janblumenkamp/rcj2015/CAD/Liste_aller_Teile.odt

Wenn nicht anders unter Bemerkung gekennzeichnet soll aus transparentem Plexiglas geschnitten werden.

Bezeichnung Dateiname Stärke Anzahl Bemerkung

Kitdropper:

- Seitenwand k_s.dxf 3mm 2x

- Seitenwand_dist k_d.dxf 3mm 2x

- Vorderwand k_v.dxf 3mm 2x

- Befestigungsleiste k_bef.dxf 3mm 2x

- Dropper k_drp.dxf 5mm 1x

- Servohalter k_srv.dxf 3mm 1x

- Rescuekits k_kit.dxf 6mm 12x farbiges Plexiglas!

- ca. 0.012m² in 3mm Stärke

- ca. 0.0013m² in 5mm Stärke

- ca. 0.00246m² in 6mm Stärke

Untere Ebene (lowerstage):

- Ebene l_e.dxf 6mm 1x

- SRF10 Halter siehe mittlere Ebene

- Sharp Senshalter s siehe mittlere Ebene

- ca. 0.0247m² in 6mm Stärke

Mittlere Ebene (middlestage):

- Ebene m_e.dxf 3mm 1x

- Sharp Senshalter l m_shl.dxf 3mm 6x

- Sharp Senshalter s m_shs.dxf 3mm 5x

- SRF10 Halter m_srf.dxf 3mm 3x

- ca. 0.05m² in 3mm Stärke

Obere Ebene (upperstage):

- Ebene u_e.dxf 4mm 1x

- ca. 0.0361m² in 4mm Stärke

GESAMT:

- ca. 0.07m² in 3mm Stärke

- ca. 0.0361m² in 4mm Stärke

- ca. 0.0013m² in 5mm Stärke

- ca. 0.03m² in 6mm Stärke

INSGESAMT ca. 0.14m²
