janblumenkamp/rcj2015/CAD/Schneiden/upperplate/upperplate.png

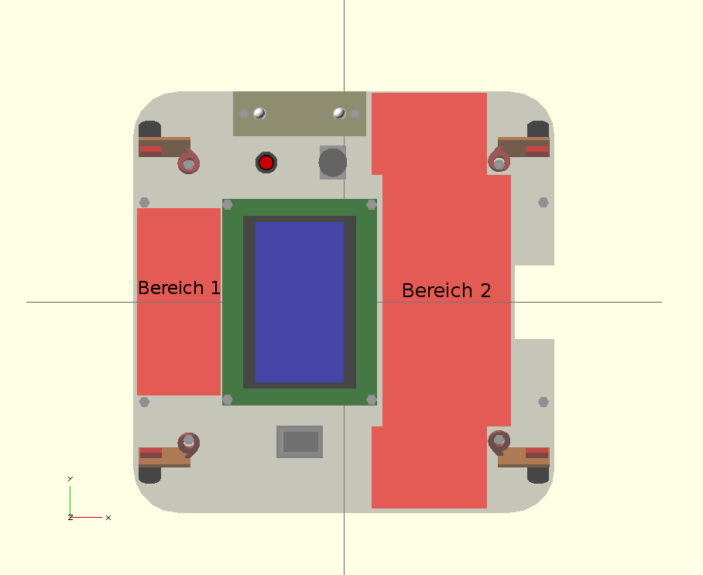
CAD/Schneiden/upperplate/upperplate.png
