janblumenkamp/rcj2015/Doku/Schaltplan/adcexpansion.png

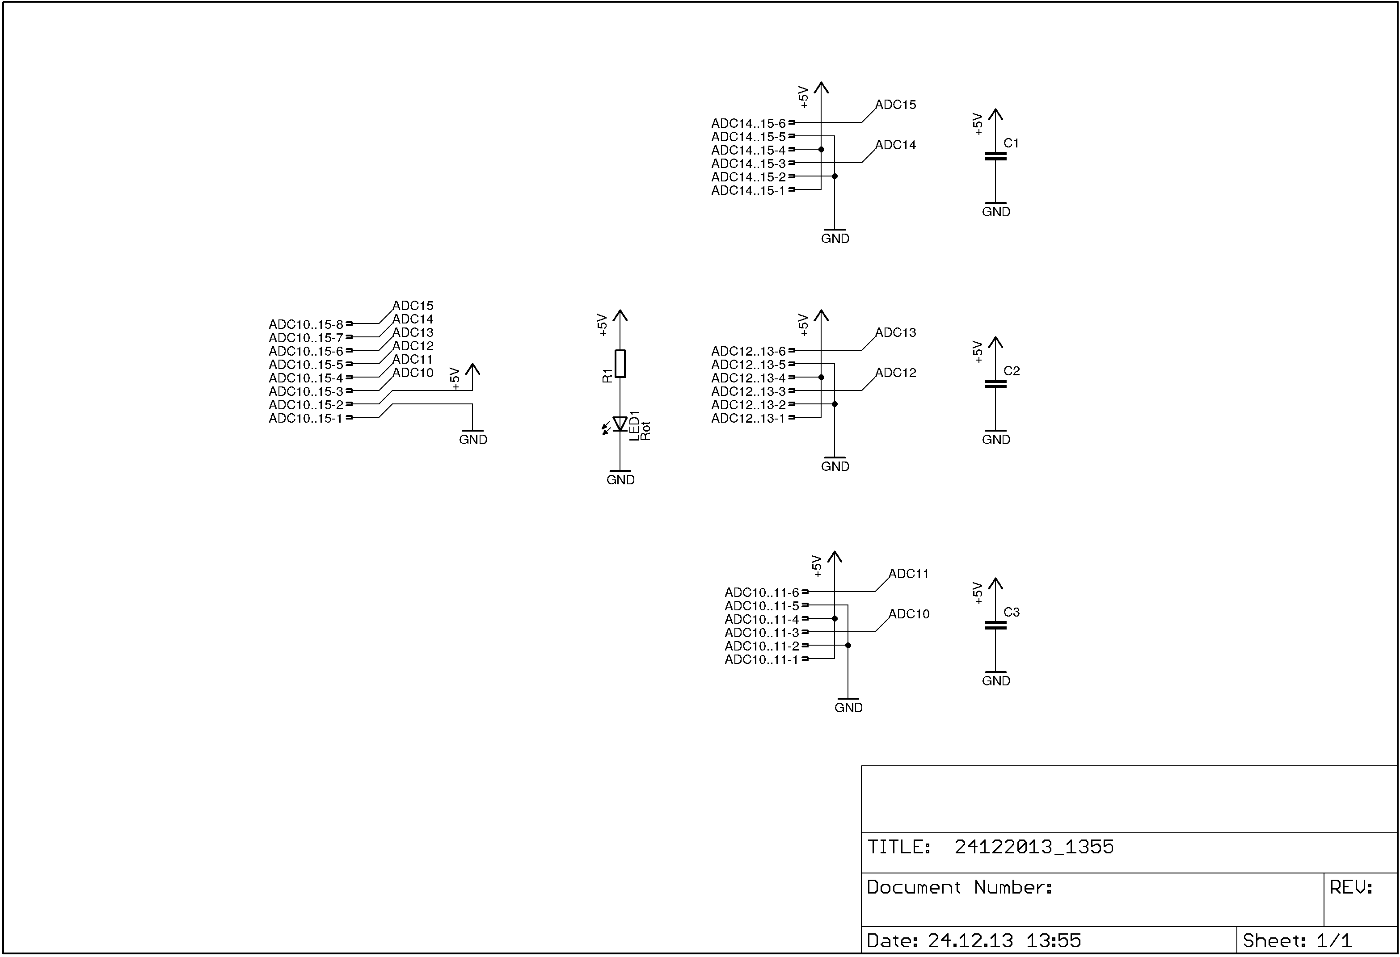
Doku/Schaltplan/adcexpansion.png
