janblumenkamp/rcj2015/Doku/Schaltplan/mainboard.png

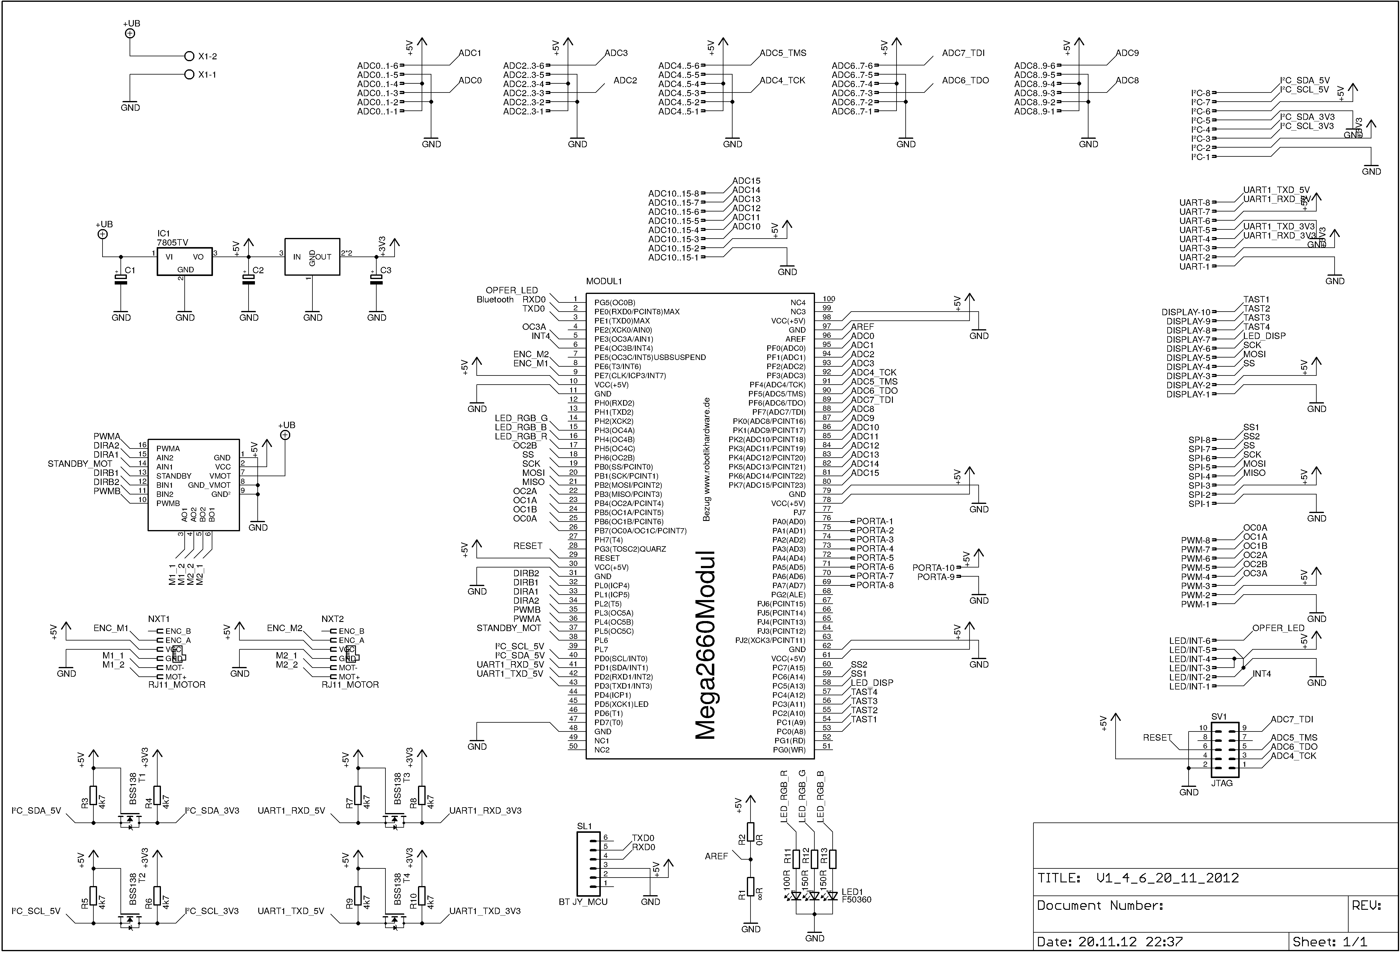
Doku/Schaltplan/mainboard.png
