janblumenkamp/rcj2015/Doku/Schaltplan/powerunit.png

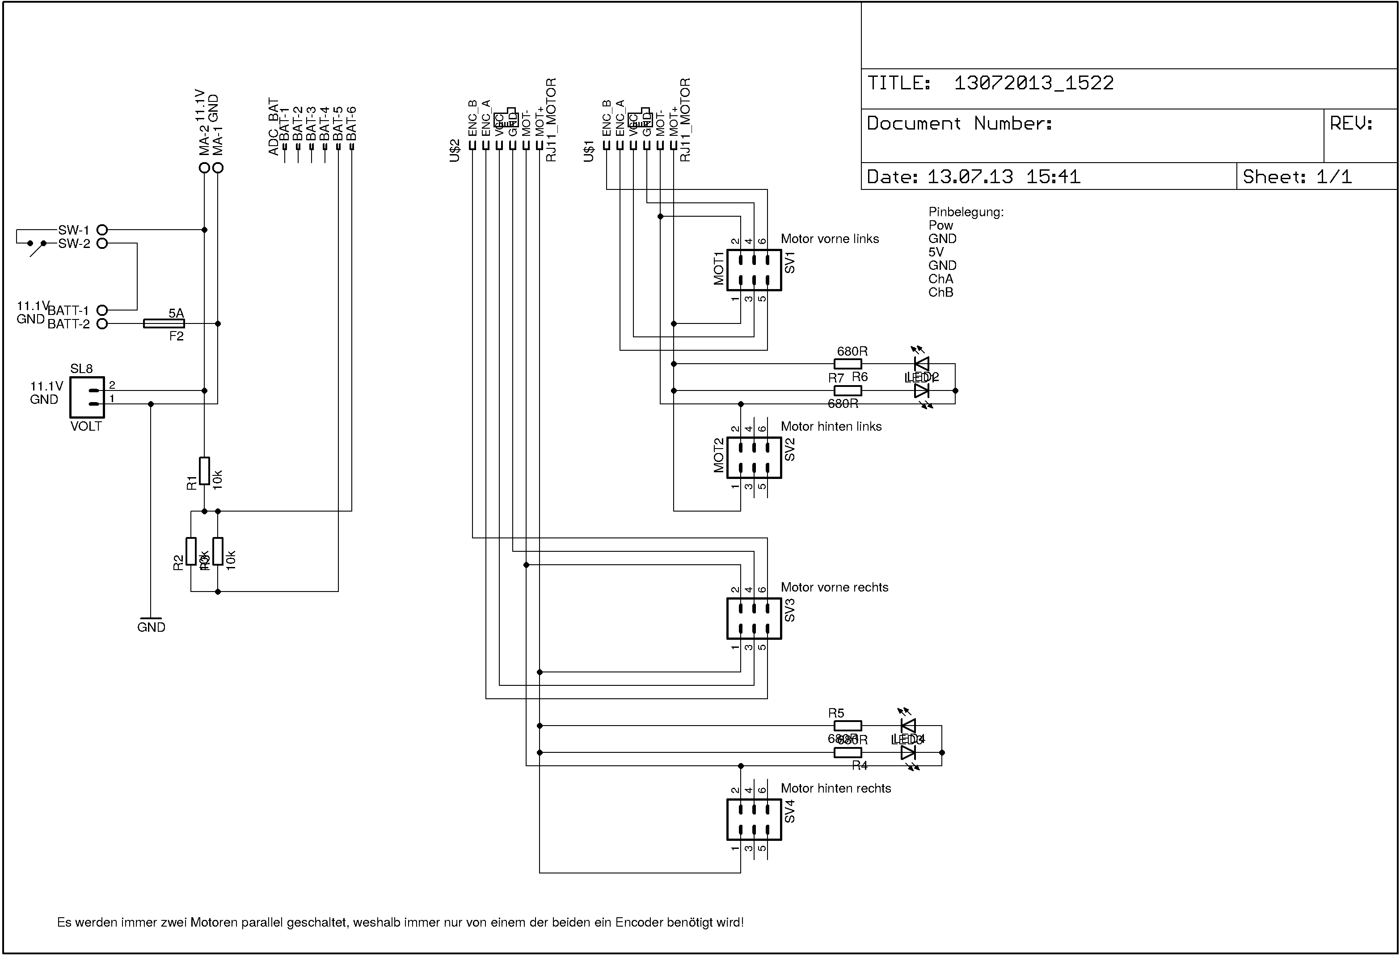
Doku/Schaltplan/powerunit.png
