janblumenkamp/rcj2015/Doku/Schaltplan/uiunit.png

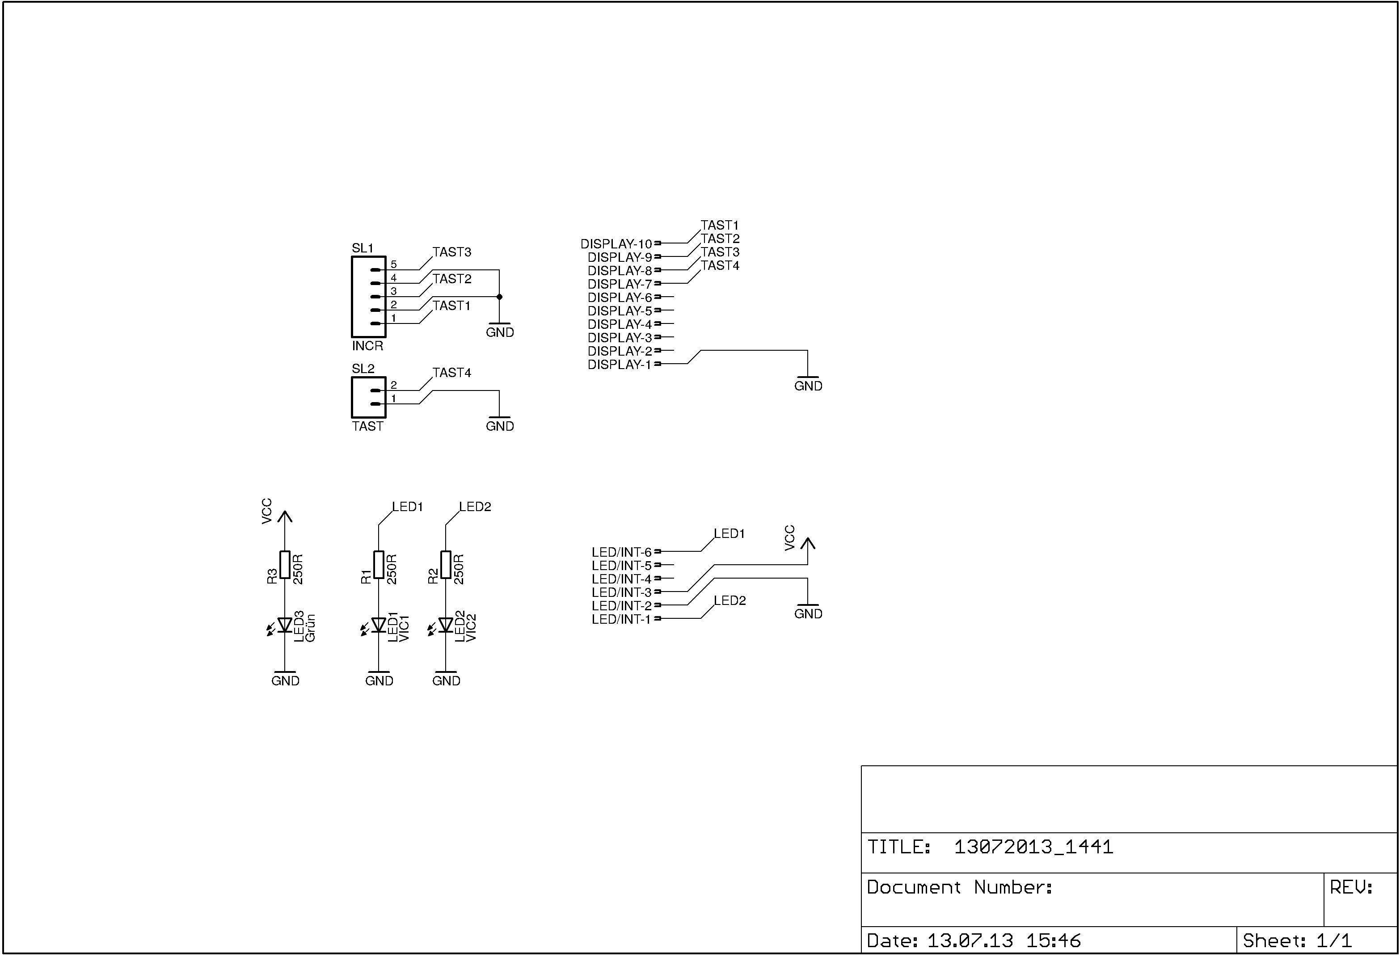
Doku/Schaltplan/uiunit.png
