janblumenkamp/rcj2015/CAD/Schneiden/AlleDateien/k_d.dxf

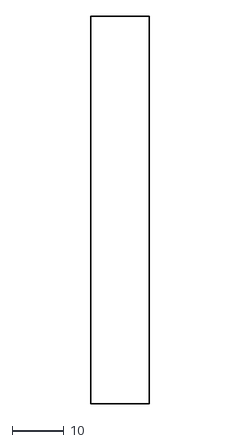
[picture p6: CAD file, 2015-02-09]
CAD/Schneiden/AlleDateien/k_d.dxf
11.2 x 74.5
