janblumenkamp/rcj2015/CAD/Schneiden/kitdropper/dropper/k_drp.dxf

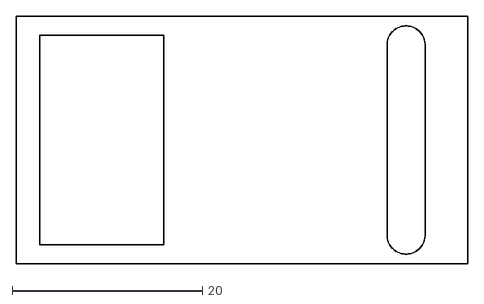
[picture p7: CAD file, 2015-02-09]
CAD/Schneiden/kitdropper/dropper/k_drp.dxf
47.5 x 26.0
