janblumenkamp/rcj2015/CAD/Schneiden/kitdropper/frontwall/k_v.dxf

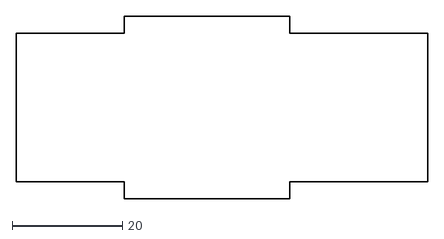
[picture p8: CAD file, 2015-02-09]
CAD/Schneiden/kitdropper/frontwall/k_v.dxf
74.5 x 33.0
