janblumenkamp/rcj2015/CAD/Schneiden/kitdropper/mounting/k_bef.dxf

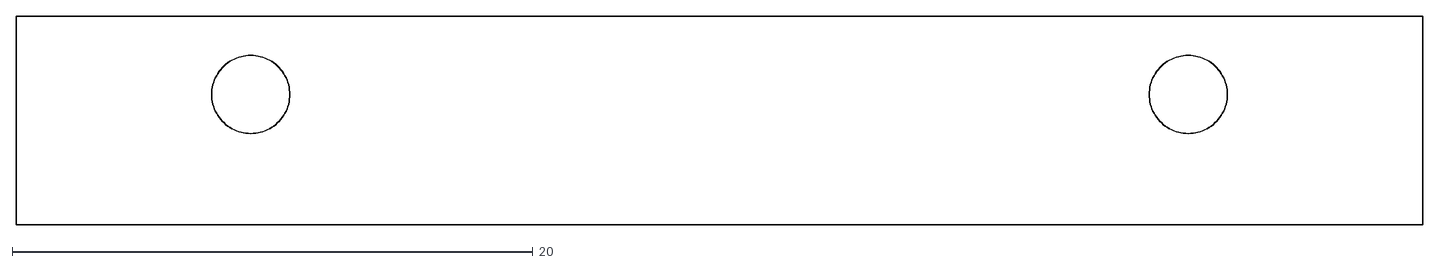
[picture p9: CAD file, 2015-02-09]
CAD/Schneiden/kitdropper/mounting/k_bef.dxf
54.0 x 8.00
