janblumenkamp/rcj2015/CAD/Schneiden/kitdropper/rescuekit/k_kit.dxf

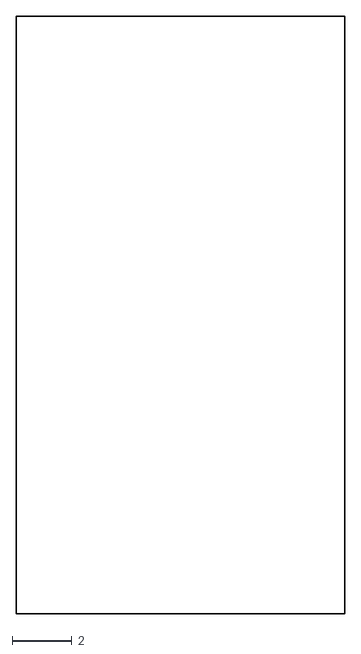
[picture p10: CAD file, 2015-02-09]
CAD/Schneiden/kitdropper/rescuekit/k_kit.dxf
11.0 x 20.0
