janblumenkamp/rcj2015/CAD/Schneiden/kitdropper/servohold/k_srv.dxf

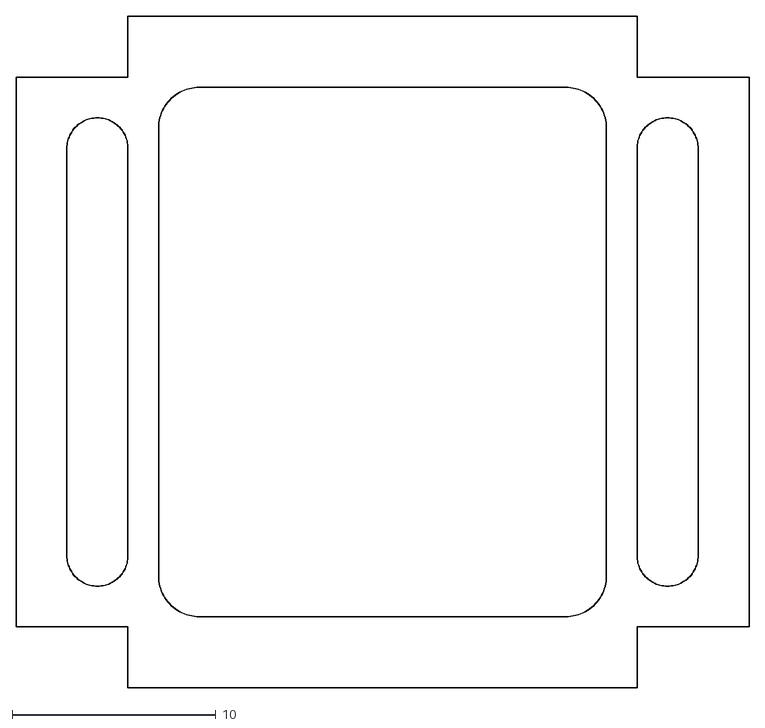
[picture p11: CAD file, 2015-02-09]
CAD/Schneiden/kitdropper/servohold/k_srv.dxf
36.0 x 33.0
