janblumenkamp/rcj2015/CAD/Schneiden/kitdropper/sidewall/k_s.dxf

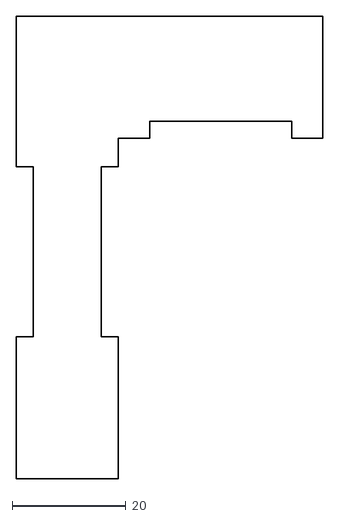
[picture p12: CAD file, 2015-02-09]
CAD/Schneiden/kitdropper/sidewall/k_s.dxf
54.0 x 81.5
