janblumenkamp/rcj2015/CAD/Schneiden/lowerplate/ebene/l_e.dxf

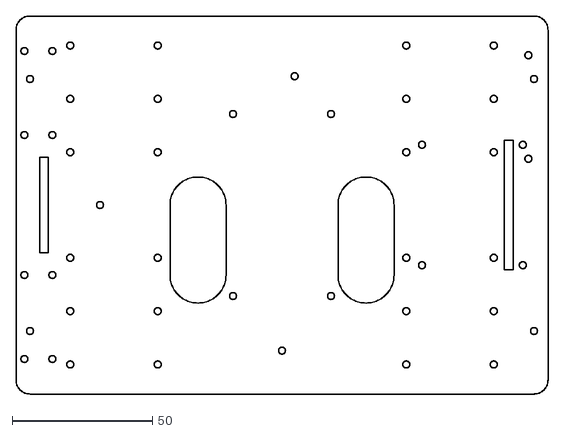
[picture p13: CAD file, 2015-02-09]
CAD/Schneiden/lowerplate/ebene/l_e.dxf
190.0 x 135.0
