janblumenkamp/rcj2015/CAD/Schneiden/middleplate/ebene/m_e.dxf

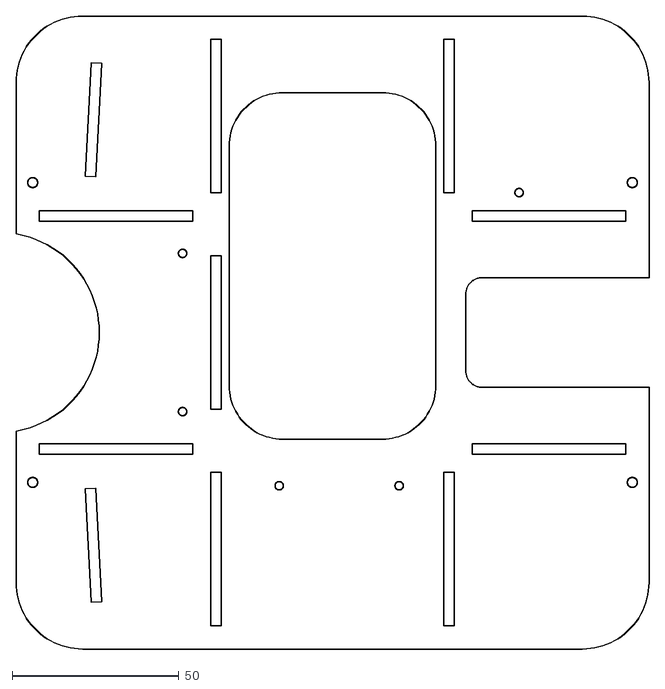
[picture p14: CAD file, 2015-02-09]
CAD/Schneiden/middleplate/ebene/m_e.dxf
190.0 x 190.0
