janblumenkamp/rcj2015/CAD/Schneiden/middleplate/sharpholder_l/m_shl.dxf

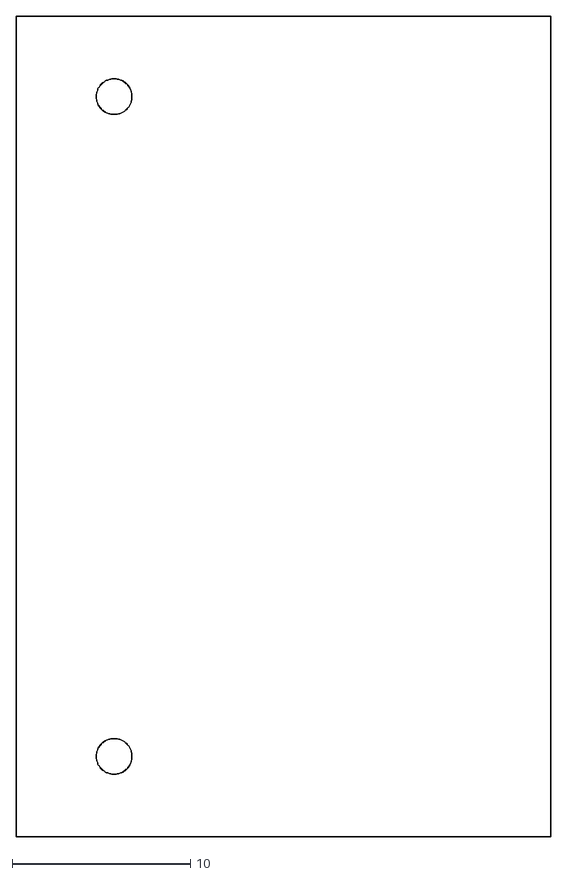
[picture p15: CAD file, 2015-02-09]
CAD/Schneiden/middleplate/sharpholder_l/m_shl.dxf
30.0 x 46.0
