janblumenkamp/rcj2015/CAD/Schneiden/middleplate/sharpholder_s/m_shs.dxf

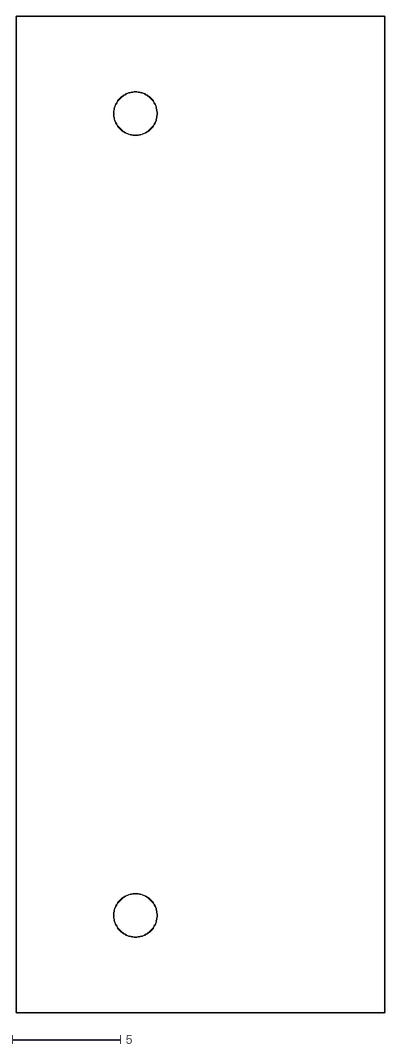
[picture p16: CAD file, 2015-02-09]
CAD/Schneiden/middleplate/sharpholder_s/m_shs.dxf
17.0 x 46.0
