janblumenkamp/rcj2015/CAD/Schneiden/middleplate/srfholder/l_srf.dxf

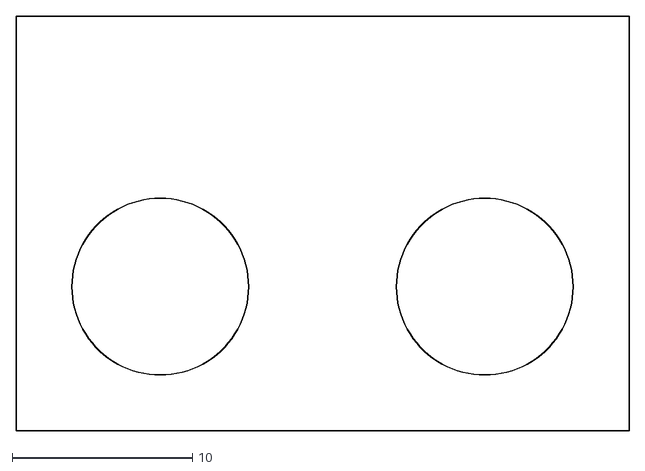
[picture p17: CAD file, 2015-02-09]
CAD/Schneiden/middleplate/srfholder/l_srf.dxf
34.0 x 23.0
