janblumenkamp/rcj2015/CAD/Schneiden/upperplate/u_e.dxf

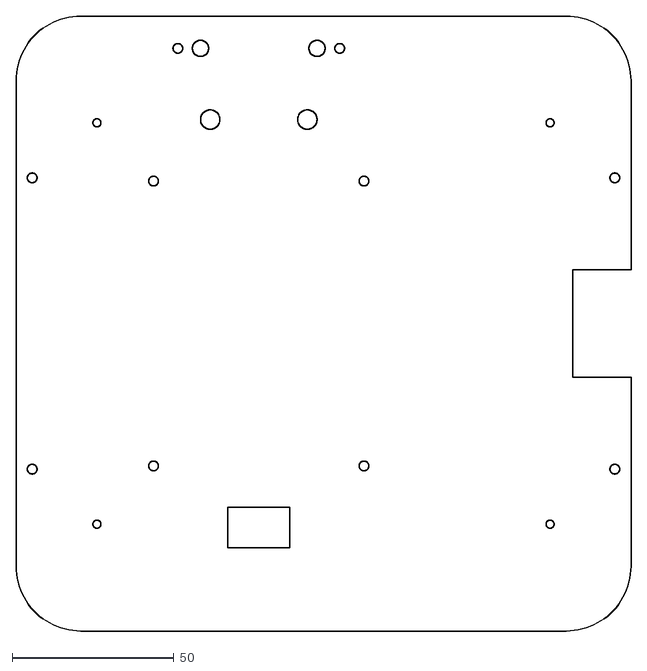
[picture p18: CAD file, 2015-02-09]
CAD/Schneiden/upperplate/u_e.dxf
190.0 x 190.0
