janblumenkamp/rcj2015/CAD/Sharp_IR_Long_Binary.stl

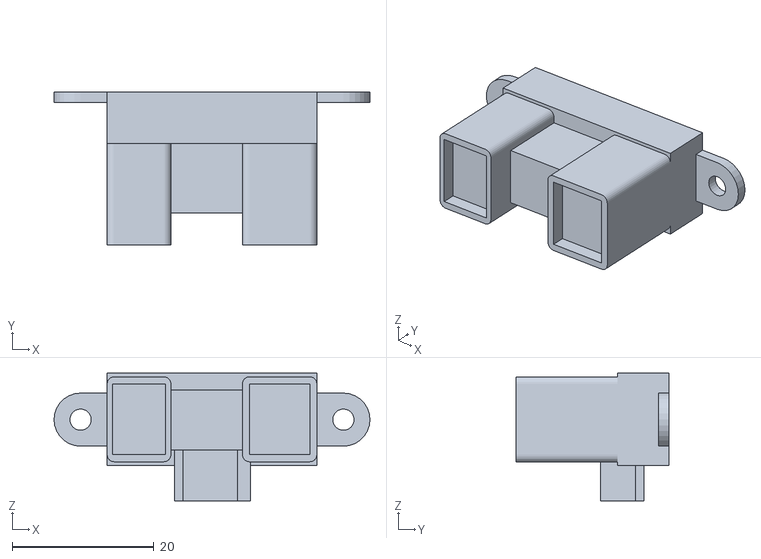
[picture p19: CAD file, 2015-02-09]
CAD/Sharp_IR_Long_Binary.stl
44.6 x 21.6 x 18.0
