janblumenkamp/rcj2015/CAD/rescuekit.stl

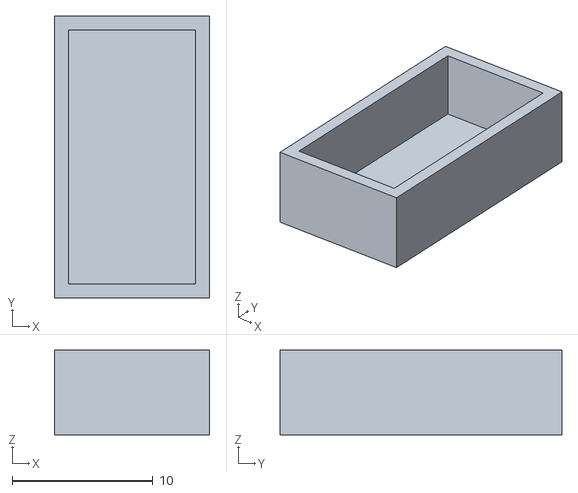
[picture p20: CAD file, 2015-02-09]
CAD/rescuekit.stl
11.0 x 20.0 x 6.00
