janblumenkamp/rcj2015/CAD/rescuekit.scad

difference()
{
	cube([11,20,6],true);
	translate([0,0,1])
	cube([9,18,6],true);
}
