janblumenkamp/rcj2015/CAD/Schneiden/kitdropper/rescuekit/k_kit.scad

$fn = 100;
length = 17;
width = 27;

projection(cut = true)
cube([length-6,width-7,6],true);
