janblumenkamp/rcj2015/CAD/Schneiden/kitdropper/sidewall/k_d.scad

$fn = 100;

projection(cut = true)
rotate([90,0,0])
cube([17-5.8,3,81.5-7],true);
