janblumenkamp/rcj2015/(list of files, cad)

Other CAD files:
CAD/logo.dxf
CAD/dat_list.dxf
CAD/kitdropper_only/kd.scad
CAD/Schneiden/upperplate/u_e.scad
CAD/Schneiden/kitdropper/dropper/k_drp.scad
CAD/Schneiden/kitdropper/frontwall/k_v.scad
CAD/Schneiden/kitdropper/mounting/k_bef.scad
CAD/Schneiden/kitdropper/sidewall/k_s.scad
CAD/Schneiden/lowerplate/ebene/lowerplate.scad
CAD/Schneiden/middleplate/ebene/m_e.scad
CAD/Schneiden/middleplate/sharpholder_l/m_shl.scad
CAD/Schneiden/middleplate/sharpholder_s/m_shs.scad
CAD/Schneiden/middleplate/srfholder/l_srf.scad
