janblumenkamp/rcj2015/Project/robocup.c

////////////////////////////////////////////////////////////////////////////////
//////////////////////////////teamohnename.de///////////////////////////////////
///////////////////////////RoboCup Junior 2014//////////////////////////////////
//////////////////////////////robocup.c/////////////////////////////////////////
////////////////////////////////////////////////////////////////////////////////
///	Kopf des Programmes mit Endlosschleife und Timer ISR
///	-> Zusammenführung sämtlicher anderer Funktionen
///		- Auswerten der Encoder und des Inkrementalgebers
///		- Timer
///		- Aufrufen der Initialisierungsfunktion
///		- Aufrufen der Navigationsfunktionen
///		- Batterieauswertung
///		- Fehleranzeige via RGB LED
///		- Opferanzeige
///		- Displayausgaben und Displayloop
////////////////////////////////////////////////////////////////////////////////
////////////////////////////////////////////////////////////////////////////////

#include "main.h"
#include "bluetooth.h"
#include "display.h"
#include "debug.h"
#include "um6.h"
#include "u8g.h"
#include "i2cmaster.h"
#include "uart.h"
#include "system.h"
#include "i2cdev.h"
#include "funktionen.h"
#include "maze.h"
#include "mazefunctions.h"
#include "drive.h"
#include "memcheck.h"
#include "victim.h"
#include "pixy.h"
#include "menu.h"
#include "adns3080.h"
#include "irdist.h"

////////////////////////////////////////////////////////////////////
//UART:
#define UART_UM6_BAUD_RATE    115200
#define UART_MCU_BAUD_RATE    115200

//////////////////////////////////////////////////////////////////////
#define WDT_TRIGGERED() if(MCUSR & (1<<WDRF)) check_res = 1;

////////////////////////////////////////////////////////////////////////////////
//Scheduler: http://www.riosscheduler.org/

task tasks[TASKS_NUM];

int8_t task_maze(int8_t state);
int8_t task_speedreg(int8_t state);
int8_t task_sensors(int8_t state);
int8_t task_anasens(int8_t state);
int8_t task_timer(int8_t state);
	
uint8_t runningTasks[TASKS_NUM+1] = {255};	//Track running tasks, [0] always idleTask
uint8_t idleTask = 255;						// 0 highest priority, 255 lowest
uint8_t currentTask = 0;					// Index of highest priority task in runningTasks

uint16_t schedule_time = 0;

////////////////////////////////////////////////////////////////////////
uint8_t check_mlx = 0;
uint8_t check_srf = 0;
uint8_t check_um6 = 0;
uint8_t check_res = 0; //resetsource?
uint8_t check_tsl = 0;
uint8_t fatal_err = 0; //Generel error, log has to be checked when it appears!
/////////////////////////////////////////////////
int32_t displayvar[DISPLAYVARS]; //Temporarly display something somewhere in the program

//////////////////////////////////////
uint8_t led_heartbeatColor = 85;	//Heartbeatcolor (0 == no heartbeat)
uint8_t led_fault = 0;				//Set to != 0, when an error has to be signalised (LED will brightly blink in the color of led_fault)
uint8_t led_top = 0;				//Point when the led swells down -> indirectly speed of led pulse/blink

#define LED_TOP_FAT_ERR 10
#define LED_TOP_NORMAL	30

#define TOGGLE_MAIN_LED() PORTD ^= (1<<PD5);
/////////////////////////////////

int8_t batt_percent = 0;
uint16_t batt_mV_old = 0xffff;
uint16_t batt_mV = 0;

//////////////////////////////////
//GLCD
uint8_t u8g_stateMachine = 0;	//Display
u8g_t u8g;						//u8g contructor

UM6_t um6; //Globale Datenstruktur deklarieren für um6
///////////////////////////////Drehgeber/Encoder/Taster/////////////////////////
#define INCR_PHASE_A     (PINC & (1<<PC1))
#define INCR_PHASE_B     (PINC & (1<<PC2))

const int8_t incr_table[16] PROGMEM = {0, 1, 0, 0, 0, 0, 0, 0, 0, 0, 0, -1, 0, 0, 0, 0};    //Steptabelle
static int8_t incr_last = 0;
int32_t incremental = 0;


#define ENC_L_PHASE_A     (PINA & (1<<PA0))
#define ENC_L_PHASE_B     (PINE & (1<<PE7))

static int8_t enc_l_last = 0;
//Encoderwert in Datenstruktur für Motoren

#define ENC_R_PHASE_A     (PINE & (1<<PE6))
#define ENC_R_PHASE_B     (PINA & (1<<PA1))

static int8_t enc_r_last = 0;
//Encoderwert in Datenstruktur für Motoren

//////////
uint8_t t1_state_off = 0; //On the beginning the robot should be off

////////////////////////////////////Sonstiges///////////////////////////////////

uint8_t setup = 0; //Start the setup?

///////////////////////////////Timer////////////////////////////////////////////

int16_t timer_victim_led = -1;
int8_t timer_entpr_tast = 0;
int8_t timer_incr_entpr = 0;
int8_t timer_bt_is_busy = 0;
int8_t timer_disp_msg = 0;
int8_t timer_motoff = 0;
int16_t timer_rdy_restart = -1;
int8_t timer_map_wall_r = 0;
int16_t timer_lop = -1;
int16_t timer_vic_ramp = -1;

uint8_t timer_25ms = 0; //make the upper timers decrement only every 25ms in the timer task

uint32_t timer = 0; //Timer, resolution 1ms, continuisly incrementing in the scheduler ISR

////////////////////////////////////////////////////////////////////////////////

ISR(TIMER1_COMPA_vect) //1kHz
{
	for(uint8_t i = 0; i < TASKS_NUM; i++) 					// Heart of scheduler code
	{
		if((tasks[i].elapsedTime >= tasks[i].period)	// Task ready
			&& (runningTasks[currentTask] > i)					// Task priority > current task priority
			&& (!tasks[i].running))											// Task not already running (no self-preemption)
		{
			cli();
			tasks[i].elapsedTime = 0;										// Reset time since last tick
			tasks[i].running = 1;												// Mark as running
			currentTask += 1;
			runningTasks[currentTask] = i;							// Add to runningTasks
			sei();

			tasks[i].state = tasks[i].task_fct(tasks[i].state);	// Execute tick

			cli();
			tasks[i].running = 0;												// Mark as not running
			runningTasks[currentTask] = idleTask;				// Remove from runningTasks
			currentTask -= 1;
			sei();
		}
		/*else if((tasks[i].elapsedTime >= tasks[i].period)	// Task ready
				&& (tasks[i].running))											// Task still running
		{
			displayvar[4] = i;
			tasks[i].period = 1000;
			tasks[i].running = 0;
		}*/
		tasks[i].elapsedTime += TASKPERIOD_GCD;
	}
}

/*### Mainloop ###*/
int main(void)
{
	WDT_TRIGGERED(); //Watchdogreset?

	init_sys();
	init_pwm();
	init_timer();
	uart1_init(UART_BAUD_SELECT(115200, F_CPU)); //IMU
	um6_init(&um6, uart1_putc, uart1_getc);
	bt_init();
	init_display(1);
	adns_init(); //Optical flow sensor (has to be called before u8g initialization!)
	//init_m2(); //Menu lib
	init_srf10();
	init_adc();
	init_i2c();
	maze_init();
	victim_init();

	for(uint8_t i = 0; i < DISPLAYVARS; i++)
		displayvar[i] = DISPLAYVAR_UNUSED;

	//The higher the task_i of the task is, the higher is the priority
	
	tasks[TASK_MAZE_ID].state = -1;
	tasks[TASK_MAZE_ID].period = TASK_PERIOD_MAZE;
	tasks[TASK_MAZE_ID].elapsedTime = 0;
	tasks[TASK_MAZE_ID].running = 0;
	tasks[TASK_MAZE_ID].task_fct = &task_maze;
	
	tasks[TASK_TIMER_ID].state = -1;
	tasks[TASK_TIMER_ID].period = TASK_PERIOD_TIMER;
	tasks[TASK_TIMER_ID].elapsedTime = 0;
	tasks[TASK_TIMER_ID].running = 0;
	tasks[TASK_TIMER_ID].task_fct = &task_timer;

	tasks[TASK_SPEEDREG_ID].state = -1;
	tasks[TASK_SPEEDREG_ID].period = TASK_PERIOD_SPEEDREG;
	tasks[TASK_SPEEDREG_ID].elapsedTime = 0;
	tasks[TASK_SPEEDREG_ID].running = 0;
	tasks[TASK_SPEEDREG_ID].task_fct = &task_speedreg;
	
	tasks[TASK_SENSORS_ID].state = -1;
	tasks[TASK_SENSORS_ID].period = TASK_PERIOD_SENSORS;
	tasks[TASK_SENSORS_ID].elapsedTime = 0;
	tasks[TASK_SENSORS_ID].running = 0;
	tasks[TASK_SENSORS_ID].task_fct = &task_sensors;

	if(get_incrOk())
	{
		motor_activate(0); //Shut down motor driver
		setup = 1;
	}
	else
	{
		motor_activate(1); //Activate motor driver
		setup = 0;
	}

	sei(); //Enable global interrupts. The Operating System and every task in it is running now

	//u8g_DrawStartUp();

	foutf(&str_debugOS, "RCJ 2014, V3.0\n\rteamohnename.de\n\r%i: System initialized.\n\r", timer);

	str_pcui.active = 0;

	if(check_res)
	{
		foutf(&str_error, "%i: WARNING: RECOVERED AFTER AN UNEXPECTED SHUTDOWN!!!\n\r", timer);
		_delay_ms(5000);
	}

	//wdt_enable(WDTO_8S); //activate watchdog

	mot.off = 1;

	t1_state_off = get_t1(); //Detection of change of state in switch (on the boot, robot is always off)

	while(1)
    {
		struct adnsData dat;
		adns_getFlowData(&dat);
		displayvar[3] = dat.quality;
		displayvar[4] += dat.delta_x;
		displayvar[5] += dat.delta_y;

		wdt_reset();

		TOGGLE_MAIN_LED(); //Toggle LED on the RNmega Board

		////////////////////////////////////////////////////////////////////////////

		maze_solveRoutes(); //Has to be called to calculate routes in main-loop, when nessesary (because it needs up to 2s)

		////////////////////////////////////////////////////////////////////////////

		if(get_t1() == t1_state_off)
		{
			mot.off = 1;
			timer_motoff = -1;
		}
		else if(timer_motoff == -1)
		{
			timer_motoff = 120;
		}
		else if(timer_motoff == 0)
		{
			mot.off = 0;
		}

		////////////////////Sensorcoordination//////////////////////////////////////

		if(check_res || fatal_err)	//Flashing of the Info LED when there is an error
			led_fault = 1;
		else if(check_mlx != 0)
			led_fault = 55;
		else if(check_srf != 0)
			led_fault = 130;
		else if(check_um6 != 0)
			led_fault = 180;
		else
			led_fault = 0;
		
		if(fatal_err)
			led_top = LED_TOP_FAT_ERR;
		else
			led_top = LED_TOP_NORMAL;
		
		//Batterie/Akku
		if(batt_raw > 0)
		{
			batt_mV = (batt_raw*15)-300;

			if(batt_mV < batt_mV_old)
			{
				batt_mV_old = batt_mV;
				batt_percent = (0.037*batt_mV) - 363;
			}
			if(batt_percent < 20) //Batterie
				led_heartbeatColor = batt_percent;
		}

		////////////////////////////////////////////////////////////////////////////
		//LED heartbeat

		led_rgb(led_heartbeatColor, led_fault, led_top);

		////////////////////////Display/Bluetooth///////////////////////////////////
		//displayvar[4] = victimBuf[LEFT].value[0];
		//displayvar[5] = (victimBuf[LEFT].value[0]-victimBuf[LEFT].lowest);

		//setup = 1;

		int8_t rampclearwall_dir = maze_getRampDir(0);
		if(rampclearwall_dir != NONE)
		{
			COORD *rampclearwall = maze_getRamp(0);

			maze_setWall(rampclearwall, maze_alignDir(rampclearwall_dir+2), -100);
		}

		pcui_sendMAP();

		if(!u8g_stateMachine)
		{
			u8g_FirstPage(&u8g);
			u8g_stateMachine = 1;
		}
		//////////////Displayausgaben////////////////

		u8g_DrawInfo(); //Message Line (upper 8 lines of lcd) in display.c!

		if(setup == 1)
			u8g_DrawSetUp();
			//m2_drawSetup();
		else if(setup == 2)
			u8g_DrawView();
		else if(setup == 3)
			u8g_DrawCamRaw();
		else if(setup == 4)
			u8g_DrawVictim();
		else
		{
			u8g_SetFont(&u8g, u8g_font_4x6);

			u8g_DrawMaze(); //Everything about the maze (in maze.c!)
			//u8g_DrawPixy();
			//u8g_DrawTempScan(LEFT);
			//u8g_DrawFrontScan();

			u8g_DrawVLine(&u8g, 87, 7, 57); //vertical line

			///////Infos//////////////////
			//  Karte   //Pfeil// Frei  //
			//          //     // hier: //
			//          /////////       //
			//          //Info //   X   //
			//          //Karte//       //
			//////////////////////////////

			if(timer_motoff < 100 && timer_motoff > 0)
			{
				u8g_SetFont(&u8g, u8g_font_fur30r);

				if(timer_motoff > 75)
					u8g_DrawStr(&u8g, 95, 50, "3");
				else if(timer_motoff > 50)
					u8g_DrawStr(&u8g, 95, 50, "2");
				else if(timer_motoff > 25)
					u8g_DrawStr(&u8g, 95, 50, "1");
			}
			else
			{
				displayvar[7] = get_mem_unused();

				for(uint8_t i = 0; i <= DISPLAYVARS; i++)
					if(displayvar[i] != 0xffff)
						u8g_DrawLong(90, i*7+15, displayvar[i]);
			}
		}

		if(!u8g_NextPage(&u8g))
		{
			u8g_stateMachine = 0;
		}
	}
	return 0;
}

////////////////////////////////////////////////////////////////////////////////
////////////////////////////TASK MAZE///////////////////////////////////////////
////////////////////////////////////////////////////////////////////////////////
int8_t testvar = 0;
uint8_t groundvar = 0;

D_DEPLOYKIT dep;
int8_t chp = 0;

int8_t task_maze(int8_t state)
{	
	if(setup == 0)
	{
		maze_solve();
	}


	/*dep.amount_to = 1;
	dep.config_dir = LEFT;
	dep.config_turnA = incremental%2; //Turn towards victim
	dep.config_turnB = incremental%2; //And turn back
	displayvar[1] = dep.config_turnA;

	if(testvar == 1)
	{
		drive_deployResKit(&dep);
		if(dep.state == DK_FINISHED)
		{
			testvar = 2;
			dep.state = DK_INIT;
		}
	}
	else
	{
		if(get_incrOk())
		{
			testvar = 1;
		}
	}*/

	return 0;
}

////////////////////////////////////////////////////////////////////////////////
//////////////////////////TASK SPEEDREG/////////////////////////////////////////
////////////////////////////////////////////////////////////////////////////////

int8_t task_speedreg(int8_t state)
{
	//Turn motor off?
	if(mot.off || mot.off_invisible)
	{
		mot.d[LEFT].speed.to = 0;
		mot.d[RIGHT].speed.to = 0;
	}

	controlSpeed(); //Speed Regulation
	
	return 0;
}

////////////////////////////////////////////////////////////////////////////////
//////////////////////////TASK SENSDIGI/////////////////////////////////////////
////////////////////////////////////////////////////////////////////////////////

int8_t task_sensors(int8_t state)
{
	//I²C sensors
	///Temperature
	check_mlx = getIR();
	victim_scan();

	//IR Dist
	irDist_get();

	//UM6
	check_um6 = um6_getUM6(&um6);
	um6_checkRamp(&um6);
	//pixy_get();

	getSRF();

	displayvar[0] = srf[0].dist;

	//analog
	get_analogSensors(); //sharp dist down, battery, groundsensor

	return 0;
}

////////////////////////////////////////////////////////////////////////////////
////////////////////////////TASK TIMER//////////////////////////////////////////
////////////////////////////////////////////////////////////////////////////////

int8_t task_timer(int8_t state)
{
	//////(rotary) encoder///////////
	//Source: http://www.mikrocontroller.net/articles/Drehgeber

	incr_last = (incr_last << 2)  & 0x0F;
	if(INCR_PHASE_A)
		incr_last |=2;
	if(INCR_PHASE_B)
		incr_last |=1;
	incremental += (int8_t)pgm_read_byte(&incr_table[incr_last]);
	
	
	int8_t new, diff;
			 
	new = 0;
	if(ENC_L_PHASE_A)		new = 3;
	if(ENC_L_PHASE_B)		new ^= 1;		// convert gray to binary
	diff = enc_l_last - new;				// difference last - new
	if( diff & 1 ){									// bit 0 = value (1)
		enc_l_last = new;							// store new as next last

		mot.d[LEFT].enc += (diff & 2) - 1;	// bit 1 = direction (+/-)
		mot.d[LEFT].enc_abs += abs((diff & 2) -1);
	}

	new = 0;
	if(ENC_R_PHASE_A)		new = 3;
	if(ENC_R_PHASE_B)		new ^= 1;		// convert gray to binary
	diff = enc_r_last - new;				// difference last - new
	if( diff & 1 ){									// bit 0 = value (1)
		enc_r_last = new;							// store new as next last
		mot.d[RIGHT].enc += (diff & 2) - 1;	// bit 1 = direction (+/-)
		mot.d[RIGHT].enc_abs += abs((diff & 2) -1);
	}

	mot.enc = ((mot.d[LEFT].enc/2) + (mot.d[RIGHT].enc/2));

	//////Timer/////////////

	timer++;
	timer_25ms ++;
	if(timer_25ms == 25) //40Hz
	{
		if(timer_victim_led > 0)
			timer_victim_led --;
		if(timer_entpr_tast > 0)
			timer_entpr_tast --;
		if(timer_incr_entpr > 0)
			timer_incr_entpr --;
		if(timer_bt_is_busy > 0)
			timer_bt_is_busy --;
		if(timer_disp_msg > 0)
			timer_disp_msg --;
		if(timer_motoff > 0)
			timer_motoff --;
		if(timer_rdy_restart > 0)
			timer_rdy_restart --;
		if(timer_map_wall_r > 0)
			timer_map_wall_r --;
		if(timer_lop > 0)
			timer_lop --;
		if(timer_vic_ramp > 0)
			timer_vic_ramp --;

		timer_25ms = 0;
	}

	return 0;
}
