janblumenkamp/rcj2015/Project/sys/maze.c

////////////////////////////////////////////////////////////////////////////////
//////////////////////////////teamohnename.de///////////////////////////////////
///////////////////////////RoboCup Junior 2014//////////////////////////////////
//////////////////////////////////maze.c////////////////////////////////////////
////////////////////////////////////////////////////////////////////////////////
///	Alles, was mit Kartierung und Navigation zu tun hat:
///	- Entscheidung (Statemachine), wie der Roboter jetzt fährt
///		- ggf. Tarry Algorithmus oder rechte Hand Regel
///	- Kartierung
///	- Anzeige der Karte und bzgl. Informationen
////////////////////////////////////////////////////////////////////////////////
////////////////////////////////////////////////////////////////////////////////

#include "main.h"
#include "maze.h"
#include "mazefunctions.h"
#include "bluetooth.h"
#include "drive.h"
#include "system.h"
#include "funktionen.h"
#include "display.h"
#include "um6.h"
#include "victim.h"
#include "i2cdev.h"

TILE maze[MAZE_SIZE_X][MAZE_SIZE_Y][MAZE_SIZE_Z];
OFF offset[MAZE_SIZE_Z]; //Für jede Ebene eigenen Offset
	int8_t offset_z; //Eigenen Offset für z, da sonst in beiden Offset [0,1] vorhanden wäre
COORD rr_result; //RouteRequest result positions
COORD off_start; //offset startposition (change startposition via rotary-encoder)
POS robot; //Positionsdaten über Roboter
POS checkpoint;
POS ramp[MAZE_SIZE_Z];		//Rampenanschlüsse

/////////////////////////////////////////////////////////////////


uint8_t maze_solve_state_path = DRIVE_READY;
uint8_t maze_solve_state_ready = 0;
uint8_t maze_solve_state_path_deplKitSave = DRIVE_READY; //In this var the value of maze_solve_state_path is stored before we deploy a rescuekit to proceed after deployment
uint8_t rt_noposs_radius = 0;

int16_t tsl_th; //Schwellwert Sackgasse; Wird aus EEPROM gelesen
int16_t tsl_th_ground;
int16_t ground_th;

uint8_t incr_ok_mode = 4; //Positions- oder Richtungswahl? Siehe auch unten

int16_t groundsens_cnt; //Count times we are below or above threshold
int16_t ramp_cnt; //Count times for threshold
int32_t ramp_enc; //check fore ramp each x driven cm

MATCHINGWALLS matchingWalls;
TILE cleartiles;

DOT dot; //drive one tail main struct!
D_TURN turn; //Turn main struct
D_DEPLOYKIT deployKits; //Deploy kits settings

uint8_t driveDot_state = 0;
int8_t checkpoint_ramp = 0;
uint8_t lastDriveAction = 0;

////////////////////////////////////////////////////////////////////////////////
// Main solving function, responsible for the decision of what will happen next,
// where the robot is going to drive, if he calculates a path etc...
//
////////////////////////////////////////////////////////////////////////////////

///Helperfunction, resets all driving functions
void maze_solve_drive_reset(void)
{
	//objects:
	dot.state = DOT_INIT;
	turn.state = TURN_INIT;
	deployKits.state = DK_INIT;
	drive_reset(); //Reset non-object orientated functions

	timer_victim_led = -1; //In case we stopped while detecting a victim
}

uint8_t maze_solve(void) //called from RIOS periodical task
{
	uint8_t returnvar = 1;

	if((timer_rdy_restart == 0) && !mot.off) //Neustart
	{
		display_setBGLED(1);
		timer_rdy_restart = -1;
		maze_init();
	}

	if((!mot.off) && (incr_ok_mode == 4)) //If the robot does not moves and there is no input
	{
		uint8_t depthsearchNum = 0;
		//////////////////////////////LOP//////////////////////////////////////

		if((maze_solve_state_path != LOP_INIT) && (maze_solve_state_path != LOP_WAIT))
		{
			if(dist_down < GROUNDDIST_TH_LOP) //Robot lifted up -> Lack of Progress
			{
				if(timer_lop == -1)
					timer_lop = TIMER_LOP_SENSOR;

				timer_rdy_restart = -1;
			}
			else
			{
				timer_lop = -1;
			}

			if(timer_lop == 0)
			{
				maze_solve_state_path = LOP_INIT;
			}
		}

		//////////////////////Statemachine///////////////////////////////////////

		switch(maze_solve_state_path)
		{
			case DRIVE_READY:
									switch(maze_solve_state_ready)
									{
										case DR_INIT:

													mot.d[LEFT].speed.to = 0;
													mot.d[RIGHT].speed.to = 0;

													um6.theta_off = um6.theta_t; //calibrate sensor

													maze_solve_state_ready = DR_UPDATEWALLS;

										case DR_UPDATEWALLS:

													if(maze_updateWalls()) //Save the walls around the robot in the MAZE_SAVESTAGE to compare it later with the environment
													{
														maze_solve_state_ready = DR_CHECK;
													}

												break;

										case DR_CHECK:

													maze_setBeenthere(&robot.pos, NONE, TRUE);

													if(((!maze_getBeenthere(&robot.pos, NORTH)) && maze_tileIsVisitable(&robot.pos, NORTH)) ||
													   ((!maze_getBeenthere(&robot.pos, EAST)) && maze_tileIsVisitable(&robot.pos, EAST)) ||
													   ((!maze_getBeenthere(&robot.pos, SOUTH)) && maze_tileIsVisitable(&robot.pos, SOUTH)) ||
													   ((!maze_getBeenthere(&robot.pos, WEST)) && maze_tileIsVisitable(&robot.pos, WEST)))
													{
														maze_clearDepthsearch();
														maze_solve_state_path = FOLLOW_RIGHTWALL; //When the program came into RESTART by RR_RTNOPOSS and there is suddenly an option (Wall wrong detected?) proceed!
													}
													else
													{
														maze_solve_state_path = FOLLOW_DFS; //Statemachine automatically jumps into FOLLOW_RIGHTWALL when there is no path possibility
													}
													maze_solve_state_ready = DR_INIT;
												break;
										default: maze_solve_state_ready = DR_INIT;
												break;
									}

								break;
						
			case FOLLOW_RIGHTWALL:
							
									if(maze_tileIsVisitable(&robot.pos, robot.dir+1) &&
									   !maze_getBeenthere(&robot.pos, robot.dir+1))
									{
										maze_solve_state_path = TURN_RIGHT;
									}
									else if(maze_tileIsVisitable(&robot.pos, robot.dir) &&
											!maze_getBeenthere(&robot.pos, robot.dir))
									{
										maze_solve_state_path = DRIVE_DOT;

										/*if(maze_getObstacle(&robot.pos, robot.dir) > 0)
										{
											if(dist[LIN][FRONT][FRONT] < 200)
											{
												maze_setObstacle(&robot.pos, robot.dir, 2);
												//maze_solve_state_path = DRIVE_READY;
											}
										}*/
									}
									else if(maze_tileIsVisitable(&robot.pos, robot.dir+3) &&
											!maze_getBeenthere(&robot.pos, robot.dir+3))
									{
										maze_solve_state_path = TURN_LEFT;
									}
									else if(maze_tileIsVisitable(&robot.pos, robot.dir+2) &&
											!maze_getBeenthere(&robot.pos, robot.dir+2))
									{
										maze_solve_state_path = TURN_LEFT;
									}
									else //No more possibilitys! Calculate Route to nearest, unvisited tile.
									{
										switch(routeRequest)
										{
											case RR_WAIT:					routeRequest = RR_CALCNEARESTTILE;	break;
											case RR_CALCNEARESTTILE:											break; //Has to be checked in maze_solveRoute()
											case RR_CALCROUTE:													break; //"
						
											case RR_RTTIMEOUT:													break; //To do... Restart?
											case RR_NEARTIMEOUT:												break; //"

											case RR_NEARDONE:
											case RR_RTDONE:					rt_noposs_radius = 0;
																			routeRequest = RR_WAIT;
																			maze_solve_state_path = FOLLOW_DFS;
																											break; //Drive via path
											case RR_NEARNOPOSS: //No unvisited tiles in the maze
						
																			rr_result = *maze_getStartPos(); //Request start position, save it in the vars for the route calculation

																			if(!maze_cmpCoords(&robot.pos, &rr_result))
																			{
																				routeRequest = RR_CALCROUTE;
																			}
																			else
																			{
																				maze_solve_state_path = RESTART; //Robot is at start Position -> Restart
																			}
									
																		break;
						
											case RR_RTNOPOSS:	//That’s bad. The robot detected a wall or black tile wrong and can’t find the way or someone put the walls from their places. ;)

																		foutf(&str_error, "ERR:NOPOSS\n\r");
																			cleartiles.beenthere = 0;
																			cleartiles.depthsearch = 1;
																			cleartiles.ground = 1;
																			cleartiles.wall_s = 1;
																			cleartiles.wall_w = 1;

																		/*	COORD c = robot.pos;

																			if((rt_noposs_radius < (MAZE_SIZE_X_USABLE)/2) &&
																				(rt_noposs_radius < (MAZE_SIZE_Y_USABLE)/2))
																			{
																				for(c.y = robot.pos.y-rt_noposs_radius; c.y <= robot.pos.y+rt_noposs_radius; c.y++)
																				{
																					for(c.x = robot.pos.x-rt_noposs_radius; c.x <= robot.pos.x+rt_noposs_radius; c.x++)
																					{
																						if((c.x >= ROB_POS_X_MIN) && (c.x <= MAZE_SIZE_X_USABLE) &&
																						   (c.y >= ROB_POS_Y_MIN) && (c.y <= MAZE_SIZE_Y_USABLE))
																								maze_clearTile(&c, &cleartiles);
																					}
																				}

																				rt_noposs_radius ++;
																				displayvar[3] = rt_noposs_radius;
																			}
																			else
																			{
																				maze_clear(&cleartiles);
																			}
*/

																			/*if(rt_noposs_radius == 0)
																			{
																				maze_setWall(&robot.pos, NORTH, 0);
																				maze_setWall(&robot.pos, EAST, 0);
																				maze_setWall(&robot.pos, SOUTH, 0);
																				maze_setWall(&robot.pos, WEST, 0);

																				maze_setGround(&robot.pos, NORTH, 0);
																				maze_setGround(&robot.pos, EAST, 0);
																				maze_setGround(&robot.pos, SOUTH, 0);
																				maze_setGround(&robot.pos, WEST, 0);

																				maze_clearDepthsearch();
																				rt_noposs_radius ++;
																			}
																			else
																			{
																				rt_noposs_radius = 0;*/
																				maze_clear(&cleartiles);
																			//}

																			maze_solve_state_path = DRIVE_READY;
																			routeRequest = RR_WAIT;//RR_NEARNOPOSS;

																		break;
											default:
																foutf(&str_error, "%i: ERR:sw[maze.18]:DEF\n\r", timer);
																fatal_err = 1;
										}
									}
				
						break;
				
			case FOLLOW_DFS:
	
									depthsearchNum = maze_getDepthsearch(&robot.pos, NONE);

									if((maze_getDepthsearch(&robot.pos, robot.dir) < depthsearchNum) &&
										maze_tileIsVisitable(&robot.pos, robot.dir))
									{
										maze_solve_state_path = DRIVE_DOT;
									}
									else if((maze_getDepthsearch(&robot.pos, robot.dir+1) < depthsearchNum) &&
											 maze_tileIsVisitable(&robot.pos, robot.dir+1))
									{
										maze_solve_state_path = TURN_RIGHT;
									}
									else if((maze_getDepthsearch(&robot.pos, robot.dir+3) < depthsearchNum) &&
											 maze_tileIsVisitable(&robot.pos, robot.dir+3))
									{
										maze_solve_state_path = TURN_LEFT;
									}
									else if((maze_getDepthsearch(&robot.pos, robot.dir+2) < depthsearchNum) &&
											 maze_tileIsVisitable(&robot.pos, robot.dir+2))
									{
										maze_solve_state_path = TURN_LEFT;
									}
									else
									{
										maze_clearDepthsearch();
										maze_solve_state_path = FOLLOW_RIGHTWALL;
									}
							
								break;
								
			case MAZE_ERR:
									fatal_err = 1;
									mot.d[LEFT].speed.to = 0;
									mot.d[RIGHT].speed.to = 0;
									
								break;
								
			case RESTART:
							
									mot.d[LEFT].speed.to = 0;
									mot.d[RIGHT].speed.to = 0;

									returnvar = 0; //0 zurückgeben, wenn fertig, sonst 1

									if(timer_rdy_restart == -1)
									{
										timer_rdy_restart = TIMER_RDY_RESTART; //Setze Timer
										display_setBGLED(0);
									}

									depthsearchNum = maze_getDepthsearch(&robot.pos, NONE);
									for(uint8_t dir = NORTH; dir <= WEST; dir++) //check for each direction
									{
										if(((maze_getDepthsearch(&robot.pos, dir) < depthsearchNum) ||
											(!maze_getBeenthere(&robot.pos, dir))) &&
											 maze_tileIsVisitable(&robot.pos, dir))
										{
											maze_clearDepthsearch();
											timer_rdy_restart = -1;
											maze_solve_state_path = FOLLOW_RIGHTWALL; //When the program came into RESTART by RR_RTNOPOSS and there is suddenly an option (Wall wrong detected?) proceed!
										}
									}

									maze_updateWalls();

									foutf(&str_debug, "%i: MAZE_DONE:RESTART: %ims\n\r", timer, timer_rdy_restart*25);

								break;

		case LOP_INIT:

								maze_solve_drive_reset(); //Reset Drive Functions...
								maze_clearDepthsearch();
								maze_clearGround();
								maze_clearRamp();

								robot.pos = *maze_getCheckpoint(&robot.pos);

								mot.off_invisible = 1;

								wall_size_part = WALL_SIZE_MEDIUM; //Detailed view of the tile

								maze_solve_state_path = LOP_WAIT;

		case LOP_WAIT:
								if(dist_down > GROUNDDIST_TH_NORMAL)
								{
									if(timer_lop == -1)
									{
										timer_lop = TIMER_LOP_RESET;
									}
									else if(timer_lop == 0)
									{
										mot.off_invisible = 0;
										wall_size_part = WALL_SIZE_STD;
										timer_lop = -1;
										maze_solve_state_path = DRIVE_READY;
									}
								}

							break;
		///////////////////////////////////////////////////////////////////////////////
		///////////////////////Drivefunctions//////////////////////////////////////////
		///////////////////////////////////////////////////////////////////////////////

		case DRIVE_DOT:
								//Check for Ramp (once)
								if((maze_getRampPosDirAtDir(&robot.pos, NONE) == robot.dir) &&
									 (robot.pos.z == 0))
								{
									maze_solve_state_path = RAMP_UP; //Rampe hoch
									break;
								}
								else if((maze_getRampPosDirAtDir(&robot.pos, NONE) == robot.dir) &&
												(robot.pos.z == 1))
								{
									maze_solve_state_path = RAMP_DOWN; //Rampe runter
									break;
								}
								else
								{
									maze_solve_state_path = DRIVE_DOT_DRIVE;

									groundsens_cnt = 0;
									ramp_cnt = 0;
									ramp_enc = mot.enc;
									driveDot_state = 0;
								}

		case DRIVE_DOT_DRIVE:

								drive_oneTile(&dot);

								if(dot.state == DOT_DRIVE) //Driving straight, not aligning -> Check for ground tiles
								{
									//Is wall  (ultrasonic low and at least )
									if((srf[0].dist <= 15) &&
										(((dist[LIN][FRONT][LEFT] > 170) &&
										 (dist[LIN][FRONT][FRONT] > 170)) ||
										((dist[LIN][FRONT][RIGHT] > 170) &&
										 (dist[LIN][FRONT][FRONT] > 170)) ||
										((dist[LIN][FRONT][LEFT] > 170) &&
										 (dist[LIN][FRONT][RIGHT] > 170))))
									{
										dot.abort = 1;
										if(driveDot_state == 1) //We crossed the tiles
										{
											driveDot_state = 0;
											switch(robot.dir)
											{
												case NORTH:	robot.pos.y--;	break;
												case EAST:	robot.pos.x--;	break;
												case SOUTH:	robot.pos.y++;	break;
												case WEST:	robot.pos.x++;	break;
												default: 	foutf(&str_error, "%i: ERR:sw[maze.02]:DEF\n\r", timer);
															fatal_err = 1;
											}
										}

										maze_setWall(&robot.pos, robot.dir, 50);
									}

									//////Check for Black and silver tile

									/*if((driveDot_state == 1) && (dot.abort == 0)) //Robot is on next tile (here can the black and silver tiles begin) and we are not driving back (aborting function)
									{

									}*/

									if((mot.enc - ramp_enc) > (ENC_FAC_CM_LR / 2))
									{
										ramp_enc = mot.enc;

										if(groundsens_l < GROUNDSENS_L_TH_CHECKPOINT) //Silver tile? Positive val
											groundsens_cnt ++;

										if((groundsens_r > GROUNDSENS_R_TH_BLACKTILE) && //Black: negative
										   (groundsens_l > GROUNDSENS_L_TH_BLACKTILE) &&
										   !um6.isRamp &&
										   !maze_getRampPosDirAtDir(&robot.pos, robot.dir))
										{
											groundsens_cnt --;

											if(groundsens_cnt < -GROUNDSENS_CNT_TH_BLACKTILE)
											{
												foutf(&str_debug, "DETECT_BLACKTILE: val: %i\n\r", groundsens_cnt);

												dot.abort = 1;
												if(driveDot_state == 0) //We are still on the old tile (before the crossing)
												{
													maze_corrGround(&robot.pos, robot.dir, 2);
												}
												else //We are already on the next tile
												{
													driveDot_state = 0;
													maze_corrGround(&robot.pos, NONE, 2);
													switch(robot.dir)
													{
														case NORTH:	robot.pos.y--;	break;
														case EAST:	robot.pos.x--;	break;
														case SOUTH:	robot.pos.y++;	break;
														case WEST:	robot.pos.x++;	break;
														default: 	foutf(&str_error, "%i: ERR:sw[maze.02]:DEF\n\r", timer);
																	fatal_err = 1;
													}
												}
											}
										}

										if(um6.isRamp > 0) //ramp up
											ramp_cnt ++;
										else if(um6.isRamp < 0) //ramp down
											ramp_cnt --;
									}

									if(((mot.enc - dot.enc_lr_start) > (TILE_LENGTH_MIN_DRIVE * ENC_FAC_CM_LR)) && !dot.abort && !driveDot_state)
									{
										switch(robot.dir)
										{
											case NORTH:	robot.pos.y++;	break;
											case EAST:	robot.pos.x++;	break;
											case SOUTH:	robot.pos.y--;	break;
											case WEST:	robot.pos.x--;	break;
											default: 	foutf(&str_error, "%i: ERR:sw[maze.02]:DEF\n\r", timer);
														fatal_err = 1;
										}

										if(robot.pos.x < ROB_POS_X_MIN)
										{
											maze_chgOffset(X, robot.pos.z, -1);
											robot.pos.x ++;
										}
										else if(robot.pos.x >= (MAZE_SIZE_X-1))
										{
											robot.pos.x = (MAZE_SIZE_X-2);
											maze_solve_state_path = RESTART;

											foutf(&str_error, "%i: ERR:robX:MemSmall_Restart\n\r", timer);
										}

										if(robot.pos.y < ROB_POS_Y_MIN)
										{
											maze_chgOffset(Y, robot.pos.z, -1);
											robot.pos.y ++;
										}
										else if(robot.pos.y >= (MAZE_SIZE_Y-1))
										{
											robot.pos.y = (MAZE_SIZE_Y-2);
											maze_solve_state_path = RESTART;

											foutf(&str_error, "%i: ERR:robY:MemSmall_Restart\n\r", timer);
										}

										driveDot_state = 1; //Position changed
									}
								}
								else if(dot.state == DOT_FINISHED)
								{
									lastDriveAction = DA_DOT;
									dot.state = DOT_INIT;

									if(!dot.abort)
									{
										if((mot.enc - dot.enc_lr_start) < 50)
										{
											maze_setWall(&robot.pos, robot.dir, 50);
										}

										foutf(&str_debug, "groundsens_cnt: %i\n\r", groundsens_cnt);

										//////////////////////////Checkpoint///////////////////

										if((groundsens_cnt > GROUNDSENS_CNT_TH_CHECKPOINT && (driveDot_state == 1))) //Checkpoint detected and robot is on next tile (no change in position)
										{
											foutf(&str_debug, "chp_detect\n\r");
											maze_setCheckpoint(&robot.pos, NONE);
										}

										/////////////////Ramp/////////////////////////

										if(maze_getRampPosDirAtDir(&robot.pos, NONE) == robot.dir)
										{
											/*if(abs(ramp_cnt) < RAMP_CNT_ISRAMP) //No ramp
											{
												foutf(&str_debug, "%i: ERR:RAMP_DEL\n\r", timer);
												maze_setRamp(&robot.pos, NONE, NONE, FALSE); //Delete Ramp
											}
											else
											{*/
												if(robot.pos.z == 0)
												{
													maze_solve_state_path = RAMP_UP;
												}
												else if(robot.pos.z == 1)
												{
													maze_solve_state_path = RAMP_DOWN;
												}
												else
												{
													foutf(&str_error, "%i: ERR:RAMP_A\n\r", timer);
												}
											//}
										}
										else if((maze_getRampDir(robot.pos.z) == NONE) && (abs(ramp_cnt) > RAMP_CNT_ISRAMP)) //no ramp stored in current robot stage, yet
										{
											foutf(&str_debug, "MAY BE RAMP: %i\n\r", ramp_cnt);

											if(ramp_cnt > RAMP_CNT_ISRAMP)
											{
												maze_solve_state_path = RAMP_UP;
											}
											else if(ramp_cnt < -RAMP_CNT_ISRAMP)
											{
												maze_solve_state_path = RAMP_DOWN;
											}
											else
											{
												foutf(&str_error, "%i: ERR:RAMP_B\n\r", timer);
											}
										}

										foutf(&str_debug, "RAMP: %i\n\r", ramp_cnt);

									}

									if(maze_solve_state_path != RAMP_DOWN && maze_solve_state_path != RAMP_UP) //If no ramp set
										maze_solve_state_path = DRIVE_READY;
								}
							break;

		case TURN_RIGHT:

								turn.r.angle = 90;
								turn.newRobDir = maze_alignDir(robot.dir + 1);


								drive_turn(&turn);

								if(turn.state == TURN_FINISHED)
								{
									turn.state = TURN_INIT;
									turn.r.progress = 0;

									robot.dir = turn.newRobDir;

									lastDriveAction = DA_TURN_R;

									maze_solve_state_path = DRIVE_READY;
								}

							break;

		case TURN_LEFT:
								turn.r.angle = -90;
								turn.newRobDir = maze_alignDir(robot.dir + 3);

								drive_turn(&turn);

								if(turn.state == TURN_FINISHED)
								{
									turn.state = TURN_INIT;
									turn.r.progress = 0;

									robot.dir = turn.newRobDir;

									lastDriveAction = DA_TURN_L;

									maze_solve_state_path = DRIVE_READY;
								}

							break;
								
		case RAMP_UP:
								if(drive_ramp(RAMP_UP_SPEED, &checkpoint_ramp) == 0)
								{
									if((mot.enc - ramp_enc_start) > (50 * ENC_FAC_CM_LR)) //Driven at least 50cm
									{
										foutf(&str_debug, "IS RAMP!\n\r");

										maze_setRamp(&robot.pos, robot.dir, NONE, TRUE); //Set ramp on button position

										if(checkpoint_ramp == 1) //Checkpoint somewhere on the ramp
										{
											maze_setCheckpoint(&robot.pos, NONE); //Robot is still on the first tile of the ramp because we haven't switched position, yet
											checkpoint_ramp = 0;
										}

										robot.pos.z ++; //normalerweise muss z jetzt 1 sein, da er die Rampe hochgefahren ist und somit unten gestartet sein muss.

										if(maze_getRampDir(robot.pos.z) == NONE) //Rampe oben noch nicht gesetzt
										{
											robot.pos.x = ROB_POS_X_MIN;
											robot.pos.y = ROB_POS_Y_MIN;

											maze_setBeenthere(&robot.pos,maze_alignDir(robot.dir + 2),TRUE);
											maze_setRamp(&robot.pos, maze_alignDir(robot.dir + 2), maze_alignDir(robot.dir + 2), TRUE);
										}
										else
										{
											robot.pos = *maze_getRamp(robot.pos.z);

											switch(maze_getRampDir(robot.pos.z))
											{
												case NORTH:	robot.pos.y--;	break;
												case EAST:	robot.pos.x--;	break;
												case SOUTH:	robot.pos.y++;	break;
												case WEST:	robot.pos.x++;	break;
												default: 	foutf(&str_error, "%i: ERR:sw[maze.02]:DEF\n\r", timer);
															fatal_err = 1;
											}
										}

										/*if(checkpoint_ramp == 2) //now, we check if the checkpoint was after the end tile of the ramp
										{
											maze_setCheckpoint(&robot.pos, NONE); //Set checkpoint to new, current tile
											checkpoint_ramp = 0;
										}*/
									}

									lastDriveAction = DA_RAMP_UP;

									maze_solve_state_path = DRIVE_READY;
								}

							break;

		case RAMP_DOWN:
								if(drive_ramp(RAMP_DOWN_SPEED, &checkpoint_ramp) == 0) //Drive ramp down
								{
									if((mot.enc - ramp_enc_start) > (50 * ENC_FAC_CM_LR)) //Driven at least 50cm
									{
										foutf(&str_debug, "IS RAMP!\n\r");

										maze_setRamp(&robot.pos, robot.dir, NONE, TRUE); //Set ramp on button position

										if(checkpoint_ramp == 1) //Checkpoint somewhere on the ramp
										{
											maze_setCheckpoint(&robot.pos, NONE); //Robot is still on the first tile of the ramp because we haven't switched position, yet
											checkpoint_ramp = 0;
										}

										robot.pos.z --; //Moved into lower stage

										if(robot.pos.z < 0) //Change offset in z axis
										{
											maze_chgOffset(Z, NONE, -1);
											robot.pos.z = 0;
										}

										if(maze_getRampDir(robot.pos.z) == NONE) //ramp in stage not yet set!
										{
											robot.pos.x = ROB_POS_X_MIN;
											robot.pos.y = ROB_POS_Y_MIN;

											maze_setBeenthere(&robot.pos,maze_alignDir(robot.dir + 2),TRUE);
											maze_setRamp(&robot.pos, maze_alignDir(robot.dir + 2), maze_alignDir(robot.dir + 2), TRUE);
										}
										else
										{
											robot.pos = *maze_getRamp(robot.pos.z); //Set robot position to ramp position in stage

											switch(maze_getRampDir(robot.pos.z))
											{
												case NORTH:	robot.pos.y--;	break;
												case EAST:	robot.pos.x--;	break;
												case SOUTH:	robot.pos.y++;	break;
												case WEST:	robot.pos.x++;	break;
												default: 	foutf(&str_error, "%i: ERR:sw[maze.01]:DEF\n\r", timer);
															fatal_err = 1;
											}
										}

										/*if(checkpoint_ramp == 2) //now, we check if the checkpoint was after the end tile of the ramp
										{
											maze_setCheckpoint(&robot.pos, NONE); //Set checkpoint to new, current tile
											checkpoint_ramp = 0;
										}*/
									}

									lastDriveAction = DA_RAMP_DOWN;

									maze_solve_state_path = DRIVE_READY;
								}

							break;

		case VIC_DEPL:
								drive_deployResKit(&deployKits);

								if(deployKits.state == DK_FINISHED)
								{
									deployKits.state = DK_INIT;

									lastDriveAction = DA_DEPLKIT;

									timer_victim_led = -1;

									maze_solve_state_path = maze_solve_state_path_deplKitSave;
								}

								break;

		case CHECK_BLACKTILE:

								maze_solve_state_path = DRIVE_DOT;

								break;
								
			default:
								foutf(&str_error, "%i: ERR:sw[maze.03]:DEF\n\r", timer);
								fatal_err = 1;
		}

		////////////////////////////////////////////////////////////////////////////////
		////////////////////////////////////////Victim//////////////////////////////////

		if((maze_solve_state_path >= DRIVE_DOT_DRIVE) && //Only if the robot is actually driving and not calculating anything
			(maze_solve_state_path <= TURN_LEFT))
		{
			if(1)//(groundsens_r < GROUNDSENS_R_TH_BLACKTILE) && (groundsens_l < GROUNDSENS_L_TH_BLACKTILE))
			{
				if((timer_victim_led < 0) && (timer_lop == -1)) //Timer not running, no Lack of progress
				{
					////////////////
					/// On victim deployment there are three cases:
					/// 1) Robot detects victim while driving straight: Turn and deploy kit left or right, then proceed driving straight
					/// 2) Robot detects victim while turning:
					///		2.1) The robot rotated only 30% of the 90°: The victim is on the old right side of the robot
					///		2.2) The robot rotated more than the 30%: The victim is on the old front side of the robot

					if(victim_BufIsVic(LEFT))
					{
						if(dist[LIN][LEFT][BACK] < DIST_VICTIM_MIN)
						{
							if((maze_getVictim(&robot.pos, robot.dir) == 0) &&
								//(maze_getVictim(&robot.pos, robot.dir+1) == 0) &&
								//(maze_getVictim(&robot.pos, robot.dir+2) == 0) &&
								(maze_getVictim(&robot.pos, robot.dir+3) == 0))
							{
								timer_victim_led = TIMER_VICTIM_LED;

								if(maze_solve_state_path == DRIVE_DOT_DRIVE)
								{
									maze_corrVictim(&robot.pos, robot.dir+3, 1);

									deployKits.amount_to = 1;
									deployKits.config_dir = LEFT;
									deployKits.config_turnBack = 1; //Turn back after deployment
									maze_solve_state_path_deplKitSave = maze_solve_state_path;
									maze_solve_state_path = VIC_DEPL;
								}
								else if((maze_solve_state_path == RAMP_UP) || (maze_solve_state_path == RAMP_DOWN)) //DONT DEPLOY, ONLY SIGNALIZE!
								{
									if(timer_vic_ramp > 0)
										timer_victim_led = -1;
								}
								else if(((maze_solve_state_path == TURN_LEFT) ||
										(maze_solve_state_path == TURN_RIGHT)) && turn.r.state == ROTATE) //Only if rotation has begin (to prevent progress being not set after ramp)
								{
									if(turn.r.progress < 70) //Robot rotates now...
									{
										maze_corrVictim(&robot.pos, robot.dir+3, 1);
									}
									else
									{
										maze_corrVictim(&robot.pos, robot.dir, 1);
									}

									deployKits.amount_to = 1;
									deployKits.config_dir = LEFT;
									deployKits.config_turnBack = 1; //Don`t turn back after deployment!
									maze_solve_state_path_deplKitSave = maze_solve_state_path;
									maze_solve_state_path = VIC_DEPL;
								}
								else
								{
									timer_victim_led = -1;
								}

								foutf(&str_debug, "%i: vicFoundL: %i degC\n\r", timer, mlx90614[LEFT].is);
							}
						}
					}
					else if(victim_BufIsVic(RIGHT))
					{
						if(dist[LIN][RIGHT][BACK] < DIST_VICTIM_MIN)
						{
							if((maze_getVictim(&robot.pos, robot.dir) == 0) &&
									(maze_getVictim(&robot.pos, robot.dir+1) == 0) )//&&
									//(maze_getVictim(&robot.pos, robot.dir+2) == 0) &&
									//(maze_getVictim(&robot.pos, robot.dir+3) == 0))
							{
								timer_victim_led = TIMER_VICTIM_LED;

								if(maze_solve_state_path == DRIVE_DOT_DRIVE)
								{
									maze_corrVictim(&robot.pos, robot.dir+1, 1);

									deployKits.amount_to = 1;
									deployKits.config_dir = RIGHT;
									deployKits.config_turnBack = 1; //Turn back after deployment
									maze_solve_state_path_deplKitSave = maze_solve_state_path;
									maze_solve_state_path = VIC_DEPL;
								}
								else if((maze_solve_state_path == RAMP_UP) || (maze_solve_state_path == RAMP_DOWN) || um6.isRamp)
								{
									if(timer_vic_ramp > 0)
										timer_victim_led = -1;
								}
								else if((maze_solve_state_path == TURN_LEFT) ||
										(maze_solve_state_path == TURN_RIGHT))
								{
									if(turn.r.progress < 70) //Robot rotates now...
									{
										maze_corrVictim(&robot.pos, robot.dir+1, 1);
									}
									else
									{
										maze_corrVictim(&robot.pos, robot.dir, 1);
									}

									deployKits.amount_to = 1;
									deployKits.config_dir = RIGHT;
									deployKits.config_turnBack = 1; //Don`t turn back after deployment!
									maze_solve_state_path_deplKitSave = maze_solve_state_path;
									maze_solve_state_path = VIC_DEPL;
								}
								else
								{
									timer_victim_led = -1;
								}

								foutf(&str_debug, "%i: vicFoundL: %i degC\n\r", timer, mlx90614[RIGHT].is);
							}
						}
					}
				}

				if(((maze_solve_state_path == RAMP_UP) || (maze_solve_state_path == RAMP_DOWN)) && (timer_victim_led == 0))
				{
					timer_victim_led = -1;
					timer_vic_ramp = TIMER_VIC_RAMP;
				}
			}
		}

		if(timer_victim_led > 0) //Timer running
		{
			//wall_size_part = WALL_SIZE_LARGE; //Detailed view of the tile

			mot.d[LEFT].speed.to = 0;
			mot.d[RIGHT].speed.to = 0;

			ui_setLED(-1, 255);
			ui_setLED(1, 255);
		}
		else
		{
			ui_setLED(-1, 0);
			ui_setLED(1, 0);
		}
	}

	return returnvar;
}

////////////////////////////////////////////////////////////////////////////////
// Organizes calculations of paths. Executed in the main loop to prevent
// blocking the whole scheduler and allowing the watchdog to break the program
// if something goes wrong!
////////////////////////////////////////////////////////////////////////////////

uint8_t routeRequest = RR_WAIT;

void maze_solveRoutes(void) //called from main-loop (time-intensive route calculations)
{
	int16_t tileRes = 0;
	
	switch(routeRequest)
	{
		case RR_WAIT:					break; //Has to be checked in maze_solve().
		
		case RR_CALCNEARESTTILE:
		
						foutf(&str_debug, "%i: CalcNearTile\n\r", timer);

						tileRes = maze_findNearestTile(&robot.pos, &rr_result);
																	 
						if(tileRes == -1)			routeRequest = RR_NEARNOPOSS; //Driven over every visitable tile -> Drive back to start
						else if(tileRes < 4000)		routeRequest = RR_CALCROUTE;
						else						routeRequest = RR_NEARTIMEOUT;
						
					break;
						
		case RR_CALCROUTE:

						foutf(&str_debug, "%i: CalcRoute\n\r", timer);

						maze_clearDepthsearch();
						
						tileRes = maze_findPath(&robot.pos, &rr_result);
						
						if(tileRes == -1)			routeRequest = RR_RTNOPOSS; //No possible route
						else if(tileRes < 4000)		routeRequest = RR_RTDONE;
						else						routeRequest = RR_RTTIMEOUT;
		
					break;
					
		case RR_NEARDONE:		break; //Has to be checked in maze_solve().
		case RR_NEARNOPOSS:		break; //"
		case RR_NEARTIMEOUT:	break; //"
		
		case RR_RTDONE:			break; //"
		case RR_RTNOPOSS:		break; //"
		case RR_RTTIMEOUT:		break; //"
		
		default:
						foutf(&str_error, "%i: ERR:sw[maze.06]:DEF\n\r", timer);
						fatal_err = 1;
						routeRequest = RR_WAIT;
	}
}

////////////////////////////////////////////////////////////////////////////////
// Updates the walls at the robot’s save position in MAZE_SAVESTAGE.
// Returns 1 if the walls were updated.
////////////////////////////////////////////////////////////////////////////////

//Helperfunction for correcting the walls with sensors in the desired direction
void maze_checkCorrWall(COORD *_coord, uint8_t sensinfoA, uint8_t sensinfoB, uint8_t dir, int16_t threshold, uint8_t updateFac_wall)
{
	if(dist[LIN][sensinfoA][sensinfoB] < threshold) //Is wall
		maze_corrWall(_coord, dir, updateFac_wall);
	else
		maze_corrWall(_coord, dir, -updateFac_wall);
}

#define DIST_FR_FAC		4 //([LEFT]/[RIGHT])[FRONT]
#define DIST_BA_FAC		2 //([LEFT]/[RIGHT])[BACK]

#define DIST_FRBA_FAC 1 //Sensore Front (nicht Mitte)
#define DIST_FRFR_FAC 7 //Mitlerer Sensor vorne
#define DIST_BABA_FAC 7 //Mitlerer Sensor hinten

uint8_t maze_updateWalls(void)
{
	//////////Wand rechts/////////////
	maze_checkCorrWall(&robot.pos, RIGHT, FRONT, robot.dir+1, SIDE_TH, DIST_FR_FAC);
	maze_checkCorrWall(&robot.pos, RIGHT, BACK, robot.dir+1, SIDE_TH, DIST_BA_FAC);

	//////////Wand links/////////////

	maze_checkCorrWall(&robot.pos, LEFT, FRONT, robot.dir+3, SIDE_TH, DIST_FR_FAC);
	maze_checkCorrWall(&robot.pos, LEFT, BACK, robot.dir+3, SIDE_TH, DIST_BA_FAC);

	//////////Wand vorne/////////////
	maze_checkCorrWall(&robot.pos, FRONT, LEFT, robot.dir, FRONT_TH, DIST_FRBA_FAC);
	maze_checkCorrWall(&robot.pos, FRONT, RIGHT, robot.dir, FRONT_TH, DIST_FRBA_FAC);
	maze_checkCorrWall(&robot.pos, FRONT, FRONT, robot.dir, FRONT_FRONT_TH, DIST_FRFR_FAC);

	//////////Wand hinten/////////////
	if(!um6.isRamp)
	{
		maze_checkCorrWall(&robot.pos, BACK, LEFT, robot.dir+2, BACK_TH, DIST_FRBA_FAC);
		maze_checkCorrWall(&robot.pos, BACK, RIGHT, robot.dir+2, BACK_TH, DIST_FRBA_FAC);
		maze_checkCorrWall(&robot.pos, BACK, BACK, robot.dir+2, BACK_BACK_TH, DIST_BABA_FAC);
	}

	//If there are enough data
	if((abs(maze_getWall(&robot.pos, NORTH)) >= MAZE_ISWALL) ||
		 (abs(maze_getWall(&robot.pos, EAST)) >= MAZE_ISWALL) ||
		 (abs(maze_getWall(&robot.pos, SOUTH)) >= MAZE_ISWALL) ||
		 (abs(maze_getWall(&robot.pos, WEST)) >= MAZE_ISWALL))
	{
		if(lastDriveAction == DA_DOT)
		{
			COORD checkObstacleProb;

			checkObstacleProb = robot.pos;
			checkObstacleProb.y ++;

			if((maze_getWall(&checkObstacleProb, NORTH) < -MAZE_ISWALL) &&
			   (maze_getWall(&checkObstacleProb, EAST) < -MAZE_ISWALL) &&
			   (maze_getWall(&checkObstacleProb, SOUTH) < -MAZE_ISWALL) &&
			   (maze_getWall(&checkObstacleProb, WEST) < -MAZE_ISWALL) &&
			   (maze_getBeenthere(&checkObstacleProb, NONE) == 0))
			{
				maze_setObstacle(&checkObstacleProb, NONE, 1);
				maze_setGround(&checkObstacleProb, NONE, 5);
			}
			else
			{
				maze_setObstacle(&checkObstacleProb, NONE, -1);
			}

			checkObstacleProb = robot.pos;
			checkObstacleProb.x ++;

			if((maze_getWall(&checkObstacleProb, NORTH) < -MAZE_ISWALL) &&
			   (maze_getWall(&checkObstacleProb, EAST) < -MAZE_ISWALL) &&
			   (maze_getWall(&checkObstacleProb, SOUTH) < -MAZE_ISWALL) &&
			   (maze_getWall(&checkObstacleProb, WEST) < -MAZE_ISWALL) &&
			   (maze_getBeenthere(&checkObstacleProb, NONE) == 0))
			{
				maze_setGround(&checkObstacleProb, NONE, 5);
				maze_setObstacle(&checkObstacleProb, NONE, 1);
			}
			else
			{
				maze_setObstacle(&checkObstacleProb, NONE, -1);
			}

			checkObstacleProb = robot.pos;
			checkObstacleProb.y --;

			if((maze_getWall(&checkObstacleProb, NORTH) < -MAZE_ISWALL) &&
			   (maze_getWall(&checkObstacleProb, EAST) < -MAZE_ISWALL) &&
			   (maze_getWall(&checkObstacleProb, SOUTH) < -MAZE_ISWALL) &&
			   (maze_getWall(&checkObstacleProb, WEST) < -MAZE_ISWALL) &&
			   (maze_getBeenthere(&checkObstacleProb, NONE) == 0))
			{
				maze_setGround(&checkObstacleProb, NONE, 5);
				maze_setObstacle(&checkObstacleProb, NONE, 1);
			}
			else
			{
				maze_setObstacle(&checkObstacleProb, NONE, -1);
			}

			checkObstacleProb = robot.pos;
			checkObstacleProb.x --;

			if((maze_getWall(&checkObstacleProb, NORTH) < -MAZE_ISWALL) &&
			   (maze_getWall(&checkObstacleProb, EAST) < -MAZE_ISWALL) &&
			   (maze_getWall(&checkObstacleProb, SOUTH) < -MAZE_ISWALL) &&
			   (maze_getWall(&checkObstacleProb, WEST) < -MAZE_ISWALL) &&
			   (maze_getBeenthere(&checkObstacleProb, NONE) == 0))
			{
				maze_setGround(&checkObstacleProb, NONE, 5);
				maze_setObstacle(&checkObstacleProb, NONE, 1);
			}
			else
			{
				maze_setObstacle(&checkObstacleProb, NONE, -1);
			}
		}

		return 1;
	}
	return 0;
}

////Schwarze Fliesen

int8_t updateGround_lastPosX = -1;
int8_t updateGround_lastPosY = -1;

void maze_updateGround(int8_t updateFac_ground, int8_t isGround)
{
	switch(robot.dir)
	{
		case NORTH:
		case EAST:
							if(maze_getWall(&robot.pos, robot.dir) < MAZE_ISWALL) //Nur, wenn da keine Wand ist
								maze_corrGround(&robot.pos, robot.dir, updateFac_ground);
								
						break;
						
		case SOUTH:
							if(((robot.pos.y-1) < 0) && (robot.pos.y != updateGround_lastPosY) && (updateFac_ground > 0))
							{
								maze_chgOffset(Y, robot.pos.z, -1);
								robot.pos.y ++;
								updateGround_lastPosY = robot.pos.y;
							}
							if(maze_getWall(&robot.pos, robot.dir) < MAZE_ISWALL) //Nur, wenn da keine Wand ist
								maze_corrGround(&robot.pos, robot.dir, updateFac_ground);
								
				break;
				
		case WEST:
							if(((robot.pos.x-1) < 0) && (robot.pos.x != updateGround_lastPosX) && (updateFac_ground > 0))
							{
								maze_chgOffset(X, robot.pos.z, -1);
								robot.pos.x ++;
								updateGround_lastPosX = robot.pos.x;
							}
							if(maze_getWall(&robot.pos, robot.dir) < MAZE_ISWALL) //Nur, wenn da keine Wand ist
								maze_corrGround(&robot.pos, robot.dir, updateFac_ground);
								
				break;
				
		default: 	foutf(&str_error, "%i: ERR:sw[maze.07]:DEF\n\r", timer);
					fatal_err = 1;
	}
		
	foutf(&str_debug, "%i: updGrnd", timer);
}

//////////////////////////////////////////////////

int8_t cursor_robot_pos_x = 0;
int8_t cursor_robot_pos_y = 0;
int8_t cursor_robot_dir = 0;
//incr_ok_mode wird oben deklariert!
int32_t incremental_old_mz = 0;

#define INCR_OK_MODE_CNT 4 //0..4 Modi (x ändern, y ändern, dir ändern, Katengröße ändern, ok)

#define CURSOR_INCR_STEP 1 //Für Positionswahl (CONST = 1 Step -> Wenn 1ncr CONST weiterzählt wird var (pos) geändert))

#define MAPEND_PART_X 70
#define MAPEND_PART_Y 63
#define MAPEND_PART_Y_TOP 7

#define MAP_ROB_POS_X MAPEND_PART_X/2
#define MAP_ROB_POS_Y (MAPEND_PART_Y-MAPEND_PART_Y_TOP)/2

int8_t wall_size_part = WALL_SIZE_STD;

void u8g_DrawMaze(void)
{
	///////Infos//////////////////
	//  Karte		//In// Frei //
	//				//fo// hier://
	//				//Ka//      //
	//    X			//rt//      //
	//				//e	//      //
	//////////////////////////////
	
	if(wall_size_part < WALL_SIZE_MIN)
		wall_size_part = WALL_SIZE_MAX;
	else if(wall_size_part > WALL_SIZE_MAX)
		wall_size_part = WALL_SIZE_MIN;

	int8_t disp_x = 0;
	int8_t disp_y = 0;
	COORD _maze;
	_maze.z = robot.pos.z;

	u8g_drawArrow(wall_size_part/2, MAP_ROB_POS_X, MAP_ROB_POS_Y, maze_alignDir(robot.dir + 3), 1);

	uint8_t map_tiles_rob_x = 0; //How many displayable tiles are at the x-achse on the left side of the robot?
	uint8_t map_tiles_rob_y = 0; //... y ...

	int8_t mapstart_x = MAP_ROB_POS_X - wall_size_part/2;
	while(mapstart_x > 0)
	{
		map_tiles_rob_x ++;
		mapstart_x -= wall_size_part;

		if(map_tiles_rob_x > MAZE_SIZE_X)
		{
			break;
			fatal_err = 1;
		}
	}
	disp_x = mapstart_x;

	int8_t mapstart_y = MAP_ROB_POS_Y + wall_size_part/2;
	while(mapstart_y < MAPEND_PART_Y)
	{
		map_tiles_rob_y ++;
		mapstart_y += wall_size_part;

		if(map_tiles_rob_y > MAZE_SIZE_Y)
		{
			break;
			fatal_err = 1;
		}
	}
	disp_y = mapstart_y;

	uint8_t map_part_size_x = MAPEND_PART_X / wall_size_part; //Size of the extract of the map
	if(MAPEND_PART_X % wall_size_part != 0)
		map_part_size_x ++;

	uint8_t map_part_size_y = MAPEND_PART_Y / wall_size_part; //Size of the extract of the map
	if(MAPEND_PART_Y % wall_size_part != 0)
		map_part_size_y ++;

	for(uint8_t maze_part_y = 0; maze_part_y <= map_part_size_y; maze_part_y++)
	{
		for(uint8_t maze_part_x = 0; maze_part_x <= map_part_size_x; maze_part_x++)
		{
			_maze.x = robot.pos.x + maze_part_x - map_tiles_rob_y;
			_maze.y = robot.pos.y + maze_part_y - map_tiles_rob_y;

			if((_maze.x >= 0) && (_maze.y >= 0) && (_maze.x < MAZE_SIZE_X) && (_maze.y < MAZE_SIZE_Y)) //Existiert die Position in der Karte?
			{
				if((disp_x < MAPEND_PART_X) && (disp_y >= MAPEND_PART_Y_TOP))
						u8g_DrawPixel(&u8g, disp_x, disp_y);

				int8_t wall_size_x_temp;
				int8_t wall_size_y_temp;

				if(maze_getGround(&_maze, NONE) > MAZE_ISBLTILE)
				{
					wall_size_x_temp = wall_size_part;
					if(((int16_t) disp_x + wall_size_part) > MAPEND_PART_X)
						wall_size_x_temp = MAPEND_PART_X-disp_x;

					wall_size_y_temp = wall_size_part;
					if(((int16_t)disp_y - wall_size_y_temp) < MAPEND_PART_Y_TOP)
						wall_size_y_temp = disp_y - MAPEND_PART_Y_TOP + 2;

					if(wall_size_y_temp > 0) //may be smaller than 0 if the box is out of the display area
						u8g_DrawBox(&u8g, disp_x+1, (uint8_t)disp_y+1-wall_size_y_temp, wall_size_x_temp-1, wall_size_y_temp-1);
				}
				else if(maze_getObstacle(&_maze, NONE) > 0)
				{
					u8g_DrawStr(&u8g, disp_x + 2, disp_y - 1, "o");
				}
				else
				{
					if(!((_maze.x == robot.pos.x) && (_maze.y == robot.pos.y))) //Where is the robot?
					{
						if((disp_x + wall_size_part-2 < MAPEND_PART_X) &&
						   (disp_x >= 0) &&
						   (disp_y - wall_size_part+2 > MAPEND_PART_Y_TOP))
						{
							if(maze_getBeenthere(&_maze, NONE))
							{
								u8g_DrawPixel(&u8g,disp_x + wall_size_part - 2, disp_y - wall_size_part + 2);
							}

							uint8_t ramp_dir = maze_getRampPosDir(&_maze);

							COORD checkpoint_disp = *maze_getCheckpoint(&robot.pos);

							if((ramp_dir != 0))
							{
								u8g_drawArrow(wall_size_part/2, disp_x+(wall_size_part/2), disp_y-(wall_size_part/2), maze_alignDir(ramp_dir + 3), 0);
							}
							else if((_maze.x == checkpoint_disp.x) && (_maze.y == checkpoint_disp.y) && (robot.pos.z == checkpoint_disp.z)) //Where is the checkpoint?
							{
								u8g_DrawLine(&u8g, disp_x, disp_y, disp_x + wall_size_part, disp_y - wall_size_part);
								u8g_DrawLine(&u8g, disp_x, disp_y - wall_size_part, disp_x + wall_size_part, disp_y);
							}
							else if((maze_getDepthsearch(&_maze, NONE) < 0xff) && (wall_size_part > 6))
							{
								if((disp_x + wall_size_part < MAPEND_PART_X) &&
								   (disp_y - wall_size_part > MAPEND_PART_Y_TOP))
								{
									u8g_DrawLong(disp_x+2, 	disp_y-2, maze_getDepthsearch(&_maze, NONE));
								}
							}
						}
					}

					//Victims
					if(wall_size_part <= WALL_SIZE_STD)
					{
						if((disp_x + wall_size_part-2 < MAPEND_PART_X) &&
						   (disp_x >= 0) &&
						   (disp_y - wall_size_part+2 > MAPEND_PART_Y_TOP))
						{
							if(maze_getVictim(&_maze, NORTH) > 0)
							{
								u8g_DrawEllipse(&u8g, disp_x + (wall_size_part/2), disp_y - wall_size_part+1, wall_size_part/6, wall_size_part/8, U8G_DRAW_LOWER_RIGHT);
								u8g_DrawEllipse(&u8g, disp_x + (wall_size_part/2), disp_y - wall_size_part+1, wall_size_part/6, wall_size_part/8, U8G_DRAW_LOWER_LEFT);
							}
							if(maze_getVictim(&_maze, EAST) > 0)
							{
								u8g_DrawEllipse(&u8g, disp_x + wall_size_part-1, disp_y - (wall_size_part/2), wall_size_part/8, wall_size_part/6, U8G_DRAW_UPPER_LEFT);
								u8g_DrawEllipse(&u8g, disp_x + wall_size_part-1, disp_y - (wall_size_part/2), wall_size_part/8, wall_size_part/6, U8G_DRAW_LOWER_LEFT);
							}
							if(maze_getVictim(&_maze, SOUTH) > 0)
							{
								u8g_DrawEllipse(&u8g, disp_x + (wall_size_part/2), disp_y-1, wall_size_part/6, wall_size_part/8, U8G_DRAW_UPPER_LEFT);
								u8g_DrawEllipse(&u8g, disp_x + (wall_size_part/2), disp_y-1, wall_size_part/6, wall_size_part/8, U8G_DRAW_UPPER_RIGHT);
							}
							if(maze_getVictim(&_maze, WEST) > 0)
							{
								u8g_DrawEllipse(&u8g, disp_x+1, disp_y - (wall_size_part/2), wall_size_part/8, wall_size_part/6, U8G_DRAW_UPPER_RIGHT);
								u8g_DrawEllipse(&u8g, disp_x+1, disp_y - (wall_size_part/2), wall_size_part/8, wall_size_part/6, U8G_DRAW_LOWER_RIGHT);
							}
						}
					}
				}

				//Wall south
				if(_maze.x < MAZE_SIZE_X-1)
				{
					int8_t wall_tmp = maze_getWall(&_maze, SOUTH);

					if(wall_tmp == 0)
					{
						for(int8_t i = disp_x + 2; i < disp_x + wall_size_part - 1; i += 2)
						{
							if((i >= 0) && (i < MAPEND_PART_X) && (disp_y >= MAPEND_PART_Y_TOP))
								u8g_DrawPixel(&u8g, i, disp_y);
						}
					}
					else if(wall_tmp > MAZE_ISWALL)
					{
						wall_size_x_temp = wall_size_part;

						if((uint8_t)(disp_x + wall_size_part) > MAPEND_PART_X)
						{
							wall_size_x_temp = MAPEND_PART_X-disp_x;
						}
						if((disp_x < MAPEND_PART_X) && (disp_y > MAPEND_PART_Y_TOP))
							u8g_DrawHLine(&u8g, disp_x, disp_y, wall_size_x_temp);
					}
				}

				//Wall west
				if(_maze.y < MAZE_SIZE_Y-1)
				{
					int8_t wall_tmp = maze_getWall(&_maze, WEST);

					if(wall_tmp == 0)
					{
						for(int8_t i = disp_y - wall_size_part + 2; i < disp_y - 1; i += 2)
						{
							if((i >= MAPEND_PART_Y_TOP) && (i <= MAPEND_PART_Y) && (disp_x < MAPEND_PART_X))
								u8g_DrawPixel(&u8g, disp_x, i);
						}
					}
					else if(wall_tmp > MAZE_ISWALL)
					{
						wall_size_y_temp = wall_size_part;
						if(disp_y - wall_size_y_temp <= MAPEND_PART_Y_TOP)
						{
							wall_size_y_temp = disp_y - MAPEND_PART_Y_TOP + 1;
						}
						if((disp_x < MAPEND_PART_X) && (disp_y > MAPEND_PART_Y_TOP))
							u8g_DrawVLine(&u8g, disp_x, disp_y-wall_size_y_temp, wall_size_y_temp);
					}
				}
			}
			disp_x += wall_size_part;
			if(maze_part_x == map_part_size_x)
			{
				disp_y -= wall_size_part;
				disp_x = mapstart_x;
			}
		}
	}

	///////Infos//////////////////
	//  Karte		//In// Frei //
	//				//fo// hier://
	//				//Ka//      //
	//				//rt//      //
	//				//eX//      //
	//////////////////////////////

	u8g_DrawVLine(&u8g, MAPEND_PART_X-1, 7, 57); //Vertikale Abgenzung

	//Positionswahl per Inkrementalgeber

	if(get_incrOk() && (timer_incr_entpr == 0) && mot.off)
	{
		incr_ok_mode ++;
		if(incr_ok_mode > INCR_OK_MODE_CNT)
			incr_ok_mode = 0;
		timer_incr_entpr = TIMER_ENTPR_INCR;

		if(incr_ok_mode == 1)
		{
			maze_solve_drive_reset(); //Fahrfunktionen zurücksetzen
			maze_clearDepthsearch();
				maze_solve_state_path = DRIVE_READY;
				routeRequest = RR_WAIT;
		}
	}

	if(incr_ok_mode != 4)
	{
		switch(incr_ok_mode)
		{
			case 0:		cursor_robot_pos_x += (incremental-incremental_old_mz)*2;		break;
			case 1:		cursor_robot_pos_y += (incremental-incremental_old_mz)*2;		break;
			case 2:		cursor_robot_dir -= (incremental-incremental_old_mz)*2;			break;
			case 3:		wall_size_part += (incremental-incremental_old_mz)*2;

						if(wall_size_part < WALL_SIZE_MIN)
							wall_size_part = WALL_SIZE_MAX;
						else if(wall_size_part > WALL_SIZE_MAX)
							wall_size_part = WALL_SIZE_MIN;
						break;
			default: 	foutf(&str_error, "%i: ERR:sw[maze.17]:DEF\n\r", timer);
						fatal_err = 1;
		}

		incremental_old_mz = incremental;

		if(cursor_robot_pos_x > CURSOR_INCR_STEP)
		{
			robot.pos.x ++;
			cursor_robot_pos_x = 0;
		}
		else if(cursor_robot_pos_x < -CURSOR_INCR_STEP)
		{
			robot.pos.x --;
			cursor_robot_pos_x = 0;
		}
		if(cursor_robot_pos_y > CURSOR_INCR_STEP)
		{
			robot.pos.y --;
			cursor_robot_pos_y = 0;
		}
		else if(cursor_robot_pos_y < -CURSOR_INCR_STEP)
		{
			robot.pos.y ++;
			cursor_robot_pos_y = 0;
		}
		if(cursor_robot_dir > CURSOR_INCR_STEP)
		{
			robot.dir --;
			if(robot.dir < NORTH)
				robot.dir = WEST;
			cursor_robot_dir = 0;
		}
		else if(cursor_robot_dir < -CURSOR_INCR_STEP)
		{
			robot.dir ++;
			if(robot.dir > WEST)
				robot.dir = NORTH;
			cursor_robot_dir = 0;
		}							

		if(robot.pos.x > (MAZE_SIZE_X-2))
		{
			robot.pos.x = ROB_POS_X_MIN;
		}
		else if(robot.pos.x < ROB_POS_X_MIN)
		{
			robot.pos.x = (MAZE_SIZE_X-2);
		}

		if(robot.pos.y > (MAZE_SIZE_Y-2))
		{
			robot.pos.y = ROB_POS_Y_MIN;
			robot.pos.z ++;
			if(robot.pos.z > (MAZE_SIZE_Z-1))
			{
				robot.pos.z = 0;
			}
		}
		else if(robot.pos.y < ROB_POS_Y_MIN)
		{
			robot.pos.y = (MAZE_SIZE_Y-2);
			robot.pos.z --;
			if(robot.pos.z < 0)
			{
				robot.pos.z = (MAZE_SIZE_Z-1);
			}
		}
		
		if(maze_GetVisitedTiles() == 0)
		{
			off_start.x = robot.pos.x - ROB_START_MAZE_X; //ROB_START_MAZE_X is added again in maze_getStart
			off_start.y = robot.pos.y - ROB_START_MAZE_Y;
			off_start.z = robot.pos.z - ROB_START_MAZE_Z;
		}
		
		timer_rdy_restart = -1;
	}
	
	switch(incr_ok_mode)
	{
		case 0:		u8g_DrawStr(&u8g, MAPEND_PART_X+1, 14, "chgx");	break;
		case 1:		u8g_DrawStr(&u8g, MAPEND_PART_X+1, 14, "chgy");	break;
		case 2:		u8g_DrawStr(&u8g, MAPEND_PART_X+1, 14, "chgd");	break;
		case 3:		u8g_DrawStr(&u8g, MAPEND_PART_X+1, 14, "sze:");
					u8g_DrawLong(MAPEND_PART_X+5, 21, wall_size_part);	break;
		case 4:		u8g_DrawStr(&u8g, MAPEND_PART_X+1, 14, "ok");		break;
		default: 	foutf(&str_error, "%i: ERR:sw[maze.18]:DEF\n\r", timer);
					fatal_err = 1;
	}
	u8g_DrawStr(&u8g, MAPEND_PART_X+1, 28, "x"); u8g_DrawStr(&u8g, MAPEND_PART_X+4, 28, ":"); u8g_DrawLong(MAPEND_PART_X+7, 28, robot.pos.x);
	u8g_DrawStr(&u8g, MAPEND_PART_X+1, 35, "y"); u8g_DrawStr(&u8g, MAPEND_PART_X+4, 35, ":"); u8g_DrawLong(MAPEND_PART_X+7, 35, robot.pos.y);
	u8g_DrawStr(&u8g, MAPEND_PART_X+1, 42, "z"); u8g_DrawStr(&u8g, MAPEND_PART_X+4, 42, ":"); u8g_DrawLong(MAPEND_PART_X+7, 42, robot.pos.z);

}
