janblumenkamp/rcj2015/Project/sys/funktionen.h

////////////////////////////////////////////////////////////////////////////////
//////////////////////////////teamohnename.de///////////////////////////////////
///////////////////////////RoboCup Junior 2014//////////////////////////////////
//////////////////////////////funktionen.h//////////////////////////////////////
////////////////////////////////////////////////////////////////////////////////
//	Siehe funktionen.c
////////////////////////////////////////////////////////////////////////////////
////////////////////////////////////////////////////////////////////////////////

#include <avr/io.h>
#include <util/delay.h>
#include <stdio.h>
#include <util/delay.h>
#include <stdlib.h>
#include <stdint.h>

#define GETANGLE_NOANGLE 10000

#define DATA_SCANFRONT_SIZE 27

#define DATA_SCANFRONT_REG_ANGLE 0 //Range (angle) of the Data (first element)
#define DATA_SCANFRONT_START 1

extern int16_t data_scanFront[DATA_SCANFRONT_SIZE + DATA_SCANFRONT_START];

extern int16_t dist[2][4][4];
extern int16_t dist_down;
extern int16_t groundsens_l;
extern int16_t groundsens_r;

extern int16_t batt_raw;

#define RAW 0
#define LIN 1
////////////////////

extern void limitVar(int16_t *var, int16_t limit);

extern void abs_ptr(int16_t *var);

extern void led_hsvToRgb (uint8_t hue, uint8_t  saturation, uint8_t value); //Farbe, Sättigung, Helligkeit

extern uint8_t rescueKit_drop(uint8_t speed);

extern void led_rgb(uint16_t heartbeat_color, uint16_t led_error, uint8_t led_top);

extern int16_t *get_sorted(uint8_t cnt, int16_t *data, uint8_t get);

extern uint8_t robot_scanFront(uint8_t angle, uint8_t maxspeed);

extern int16_t get_adc(uint8_t channel);

extern void dist_setSensors(uint8_t block, uint8_t set);

extern void get_analogSensors(void);

extern int16_t robot_getAngleToWall(uint8_t dir);
