janblumenkamp/rcj2015/Project/sys/adns3080.h

#ifndef ADNS3080_H
#define ADNS3080_H

// ADNS3080 hardware config
#define ADNS3080_PIXELS_X                 30
#define ADNS3080_PIXELS_Y                 30
#define ADNS3080_CLOCK_SPEED			  24000000

// Register Map for the ADNS3080 Optical OpticalFlow Sensor
#define ADNS3080_PRODUCT_ID            0x00
#define ADNS3080_REVISION_ID           0x01
#define ADNS3080_MOTION                0x02
#define ADNS3080_DELTA_X               0x03
#define ADNS3080_DELTA_Y               0x04
#define ADNS3080_SQUAL                 0x05
#define ADNS3080_PIXEL_SUM             0x06
#define ADNS3080_MAXIMUM_PIXEL         0x07
#define ADNS3080_CONFIGURATION_BITS    0x0a
#define ADNS3080_EXTENDED_CONFIG       0x0b
#define ADNS3080_DATA_OUT_LOWER        0x0c
#define ADNS3080_DATA_OUT_UPPER        0x0d
#define ADNS3080_SHUTTER_LOWER         0x0e
#define ADNS3080_SHUTTER_UPPER         0x0f
#define ADNS3080_FRAME_PERIOD_LOWER    0x10
#define ADNS3080_FRAME_PERIOD_UPPER    0x11
#define ADNS3080_MOTION_CLEAR          0x12
#define ADNS3080_FRAME_CAPTURE         0x13
#define ADNS3080_SROM_ENABLE           0x14
#define ADNS3080_FRAME_PERIOD_MAX_BOUND_LOWER      0x19
#define ADNS3080_FRAME_PERIOD_MAX_BOUND_UPPER      0x1a
#define ADNS3080_FRAME_PERIOD_MIN_BOUND_LOWER      0x1b
#define ADNS3080_FRAME_PERIOD_MIN_BOUND_UPPER      0x1c
#define ADNS3080_SHUTTER_MAX_BOUND_LOWER           0x1e
#define ADNS3080_SHUTTER_MAX_BOUND_UPPER           0x1e
#define ADNS3080_SROM_ID               0x1f
#define ADNS3080_OBSERVATION           0x3d
#define ADNS3080_INVERSE_PRODUCT_ID    0x3f
#define ADNS3080_PIXEL_BURST           0x40
#define ADNS3080_MOTION_BURST          0x50
#define ADNS3080_SROM_LOAD             0x60

// Configuration Bits
#define ADNS3080_LED_MODE_ALWAYS_ON        0x00
#define ADNS3080_LED_MODE_WHEN_REQUIRED    0x01

#define ADNS3080_RESOLUTION_400			400
#define ADNS3080_RESOLUTION_1600		1600

// Extended Configuration bits
#define ADNS3080_SERIALNPU_OFF	0x02

#define ADNS3080_FRAME_RATE_MAX         6469
#define ADNS3080_FRAME_RATE_MIN         2000

///////////////////////////////////////////////////////////////



struct adnsData {
	uint8_t quality;
	int8_t delta_x;
	int8_t delta_y;
};

////////////////////////////////////////////////////////////

extern void adns_init(void);

extern void adns_setSlaveSelect(uint8_t select);

extern void adns_reset(void);

extern uint8_t adns_readRegister(uint8_t reg);

extern void adns_writeRegister(uint8_t reg, uint8_t val);

extern void adns_getFlowData(struct adnsData *data);

#endif // ADNS3080_H
