janblumenkamp/rcj2015/Project/sys/spimaster.h

#ifndef SPIMASTER_H
#define SPIMASTER_H

#include <avr/io.h>

extern void spi_init(void);
extern void spi_transfer_sync(uint8_t * dataout, uint8_t * datain, uint8_t len);
extern void spi_transmit_sync(uint8_t * dataout, uint8_t len);
extern uint8_t spi_fast_shift(uint8_t data);

#endif // SPIMASTER_H
