janblumenkamp/rcj2015/Project/sys/display.h

////////////////////////////////////////////////////////////////////////////////
//////////////////////////////teamohnename.de///////////////////////////////////
///////////////////////////RoboCup Junior 2014//////////////////////////////////
/////////////////////////////////display.h//////////////////////////////////////
////////////////////////////////////////////////////////////////////////////////
//	siehe display.c
////////////////////////////////////////////////////////////////////////////////
////////////////////////////////////////////////////////////////////////////////

#include <avr/io.h>
#include <util/delay.h>
#include <stdio.h>
#include <util/delay.h>
#include <stdlib.h>
#include <stdint.h>
#include <avr/eeprom.h>

/////////////////////////////////

extern void init_m2(void);

extern void u8g_DrawLong(uint8_t koord_x, uint8_t koord_y, int32_t num);

extern void u8g_DrawStartUp(void);

extern void u8g_drawArrow(uint8_t size, uint8_t pos_x, uint8_t pos_y, uint8_t dir, int8_t mode);

extern void u8g_DrawInfo(void);

extern void u8g_DrawSetUp(void);

extern void u8g_DrawView(void);

extern void u8g_DrawCamRaw(void);

extern void u8g_DrawVictim(void);

extern void u8g_DrawPixy(void);

extern void u8g_DrawFrontScan(void);

extern void u8g_DrawTempScan(uint8_t dir);
