janblumenkamp/rcj2015/(commit log)

2015-01-05 INITIAL COMMIT
    First commit. Start is the mainly working project of rcj2014.
    Known Bugs: Black tiles!
    [bluetooth.c, bluetooth.h, debug.c, debug.h, display.c, display.h, drive.c]
2015-01-21 Major commit: Robot restoring... The program was the software of the superteam, so many things hat do be changed back. Now everything seems to work, except for the black tile bug.
    [drive.c, funktionen.c, maze.c, maze.h, mazefunctions.c, mazefunctions.h, robocup.c, system.c]
2015-01-24 Major commit: Drive one tile object orientated Make driving one tile object orientated to theoretically drive multiple one tiles at once. Re-structrization due to blacktile bug
    [drive.c, drive.h, main.h, maze.c, maze.h, mazefunctions.c, robocup.c]
2015-01-27 Optimizations: Black tile recognition Known Bug: Mapmatching somehow not working...
    [drive.c, drive.h, maze.c, robocup.c]
2015-01-29 Minor changes/Optimization, bug fixed (drive one tile encoder bug/tiles jumped)
    [drive.c, drive.h, maze.c, maze.h, robocup.c]
2015-01-30 The robot switch to next position after driven distance was removed. In this commit, it was inserted again. Also minor tests/optimizations.
2015-01-30 Bug fixed: Deploy rescuekit
    [drive.c, maze.c, maze.h, robocup.c]
2015-01-31 Bug fixed: The walls were only updated until they are above a threshold. Now the walls are always updated and at least until they are above a threshold.
    [maze.c, robocup.c]
2015-02-04 RoboCup qualification Oldenburg 1: major commit
    - Workaround: there was a bug (hardware) with the red motor off button. It randomly went to 1. The mot.off function was completely removed
    - Workaround: The wall behind the ramp was always drawed into the map. In the main loop, we now check if a ramp was created and if so we always set the wall behind the ramp to -100.
    - deployResKit optimizations: only drive back if there is enough place. If driven back, also drive forward again
    - No signalizing of victims on ramp (not nessesary on pre-qualification)
    - Optimizations: Thresholds adapted
    [display.c, drive.c, drive.h, maze.c, mazefunctions.c, robocup.c]
2015-02-04 first approaches to solve the t1 button bug (you have to push it for 1.3s), groundsens: only start incrementing after first part of tile, victim in turn state: wait until rtation has actually started
    [main.h, maze.c, robocup.c]
2015-02-05 Minor changes, KNOWN BUGS: Temperature...
    - Button stop: Make it an inversed dead-man-button (you have to keep pushing it to stop the robot)
    - victim draw scan/debug/setup: set the desired sensor (left/right) via incremental
    - ramp thresholds...
    [display.c, drive.c, main.h, maze.c, robocup.c, victim.c]
2015-02-05 many test changes, something is wrong
    [drive.h, main.h, maze.c, robocup.c, victim.c, victim.h]
2015-02-05 Workaround: Bug fixed: Victim identification. There are some problems in the victim identification state machine. It was re-programmed really simple as workaround here... Known bugs on the ramp (some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
    [drive.h, main.h, maze.c, robocup.c, victim.c, victim.h]
2015-02-05 BUG FIXED: Victim not identificating. The problem only occured while driving straight. The robot drives straight, if it is in the state DRIVE_DOT_DRIVE, but in the victim statemachine, only the case 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
    [maze.c]
2015-02-05 Tile visualization bug fixed (sometimes the tile was displayed outside the display area
    [maze.c]
2015-02-06 Bug fixed: Clear depthsearch after switching to follow-rightwall mode, threshold optimizations
    [drive.h, maze.c]
2015-02-09 CAD Files and Schematic images added
    [Sharp_IR_Long_Binary.stl, dat_list.dxf, electro.scad, k_bef.dxf, k_bef.scad, k_d.dxf, k_d.scad, k_drp.dxf]
2015-02-21 Added optical flow SPI camera. Datas currently only visualized on display, probably buggy... Has to be optimized!
    [adns3080.c, adns3080.h, robocup.c, spimaster.c, spimaster.h, system.c]
2015-03-03 Implemented map streaming. Still has to be tested, but probably something is with the type conversions wrong.
    [debug.c, debug.h, maze.c, maze.h, robocup.c]
2015-03-20 implemented var isRamp into um6 structure to check if the robot is on the ramp. We dont need the relative comparison anymore, there is no drift in this axis. In case the robot rotates by 360°, we use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
    [maze.c, maze.h, robocup.c, um6.c, um6.h]
2015-03-20 UM6 Lib now completely object orientated, completely capsuled (also with uart get/put function pointer)
2015-04-15 ramp recognition optimized, bug fixed (robot starts in upper stage)
    [maze.c]
2015-04-15 ramp drive function re-implemented, checkpoints at the end of the ramp are recognized and work, the ramp functions can also recognize checkpoints *on* the ramp, but this is currently commented out in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
    [drive.c, drive.h, maze.c, pixy.c, robocup.c]
2015-04-23 - displayoutput groundsens_l and r - driveOneTile: define maximum speed in dot datastruct, so that we can increase the speed if we detect an obstacle - we divide the threshold in which we align to th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
    [display.c, drive.c, drive.h, maze.c, maze.h, mazefunctions.c, um6.c]
2015-04-24 fixed some UI bugs (UI is still buggy, but works at least now...). Also adapted checkpoints
    [display.c, maze.c, maze.h, robocup.c, victim.c]
2015-04-24 Optimizations/bug fixes in UI, ramp: we have to drive a certain distance (currently 50cm) on the ramp before we write the ramp into the map, thresholds adjusted (aligning on the front wall while driv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
    [display.c, drive.c, drive.h, main.h, maze.c, maze.h]
2015-04-24 IR temperature sensors via absolute threshold (before: relative), works way better! Align back only if all three sensors are below threshold. Also minor threshold optimizations.
2015-04-25 First tests in maze loop. not working.
    [maze.c]
2015-04-25 changed signs of wall threshold, but still not working
    [maze.c]
2015-04-25 - removed changes from master (orientation change in drive rotate function) - groundsens, silver tile and ramp: count on whole tile and via incremental (all 0.5 cm) - thresholds: changed adapted - in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
2015-06-23 Major commit: new distance sensors (GP2YE03) replacing the old analoge ones. Removed unnessesary lines.
2015-06-25 First test methods for un-activating sensors via I2c
    Switch on robot depends on start after boot
2015-06-29 IR dist optimizations (only one sensor per direction active due to interferences), removed unnessesary lines in the drive one tile function (as they were corrections for the interferences), adapted t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
    [drive.c, drive.h, irdist.c, irdist.h, main.h, robocup.c]
2015-06-30 Drive: Bug fixed with automatic direction alignment without walls!
    Tests with obstacles... Not yet working
    [drive.c, drive.h, maze.c, maze.h, mazefunctions.c, robocup.c, system.c, um6.c]
2015-06-30 minor optimizations with dist sensor offsets, thresholds
2015-07-19 Changes of constants, minor optimizations with victim LED
2015-07-19 removed collision avoidance via front distance sensors and adapted threshold for silver tile
    [drive.c, maze.h]
2015-07-19 increased restart time to 45s and switching display background led of during this time
2015-07-20 Adapted Thresholds, added a front sensor judgement (due to bad sensor readings on victims)
2015-07-20 Implemented obstacle handling with obstacles in the middle of tiles based on an ultrasonic sensor
2015-07-20 re-inserted the collision avoidance via front sensors and adjusted thresholds
    [drive.c, drive.h, maze.h]
